ninjaiceflame/MotorizedDobsonian/Documentation/Photos/Week 4/Screenshot_20221017-213734_Amazon Shopping.jpg

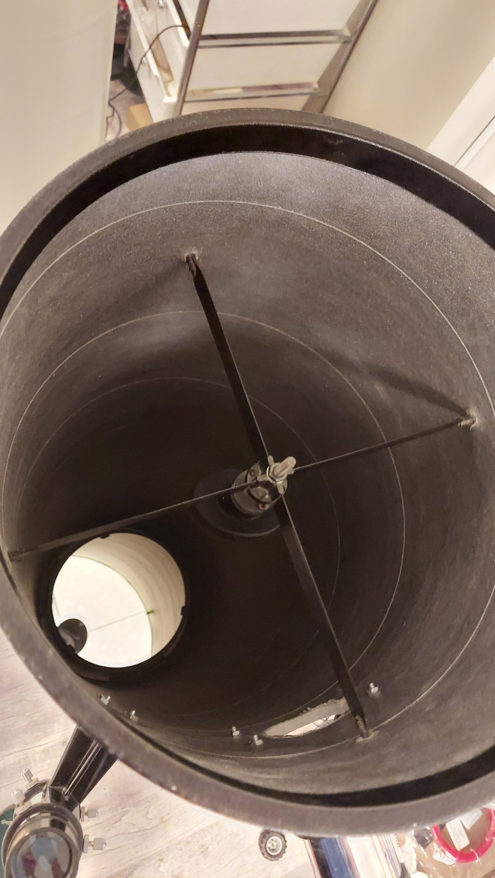
Documentation/Photos/Week 4/Screenshot_20221017-213734_Amazon Shopping.jpg
