ninjaiceflame/MotorizedDobsonian/Documentation/Photos/Week 9/20230317_074437.jpg

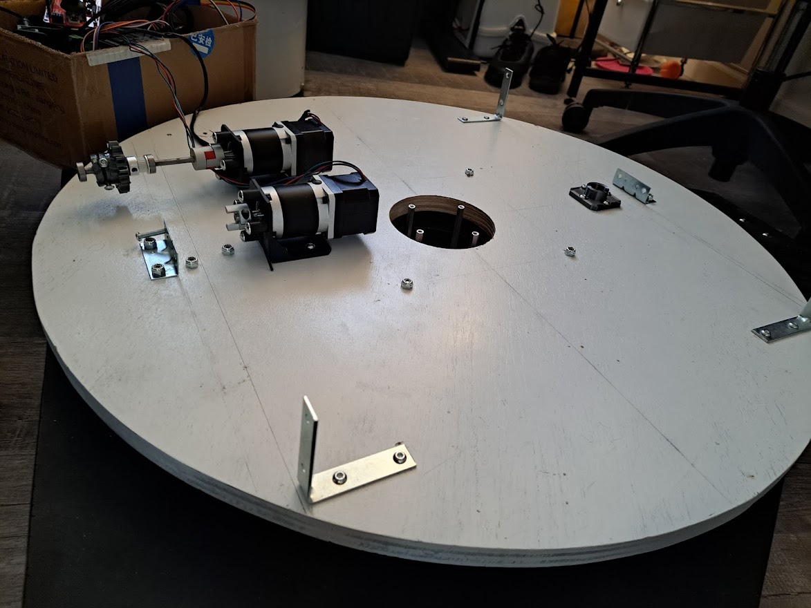
Documentation/Photos/Week 9/20230317_074437.jpg
