ninjaiceflame/MotorizedDobsonian/Documentation/Peer Design Review.pptx

## PEER DESIGN REVIEW Powered Dobsonian Telescope Nathan Wiley

Submitted in partial fulfillment of the requirements of CST471
ESET Senior Project, Oregon Institute of Technology.

## Agenda:

- The Problem and Solution
- Designs, Features, and Progress
- Block Diagram
- Part Selection
- Calculations
- Cost
- Schedule

## The Problem:

Telescopes are not automated enough!
Need to be present to punch in coordinates
- Cold
- Clunky
- Outdated

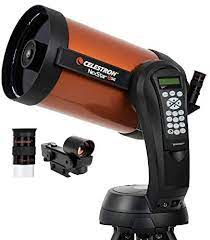
[picture p29: figure]
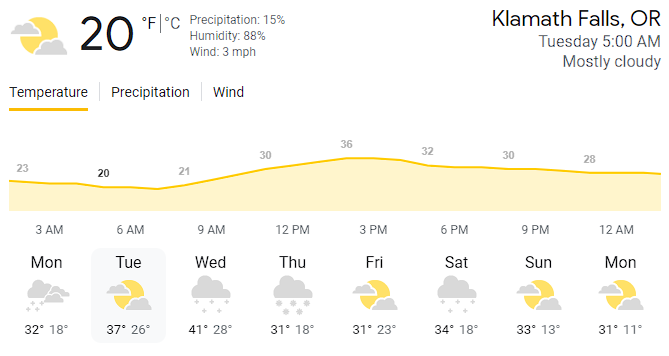
[picture p30: figure]

## The Solution:

Make a telescope that you can control from your couch!

## Design & Features:

Requirements (Very condensed)
1. Shall pivot a telescope
(accuracy to 3600 arcseconds / 1 degree)
2. Shall be able to keep accurate time
3. Shall use a control system
4. Shall have a network interface
5. Shall use a display

Stretch goals
1. May have a camera
2. May use RTC module
3. May include GPS module
4. May include Wi-Fi and Ethernet
5. May include cooling system

## Design process and progress:

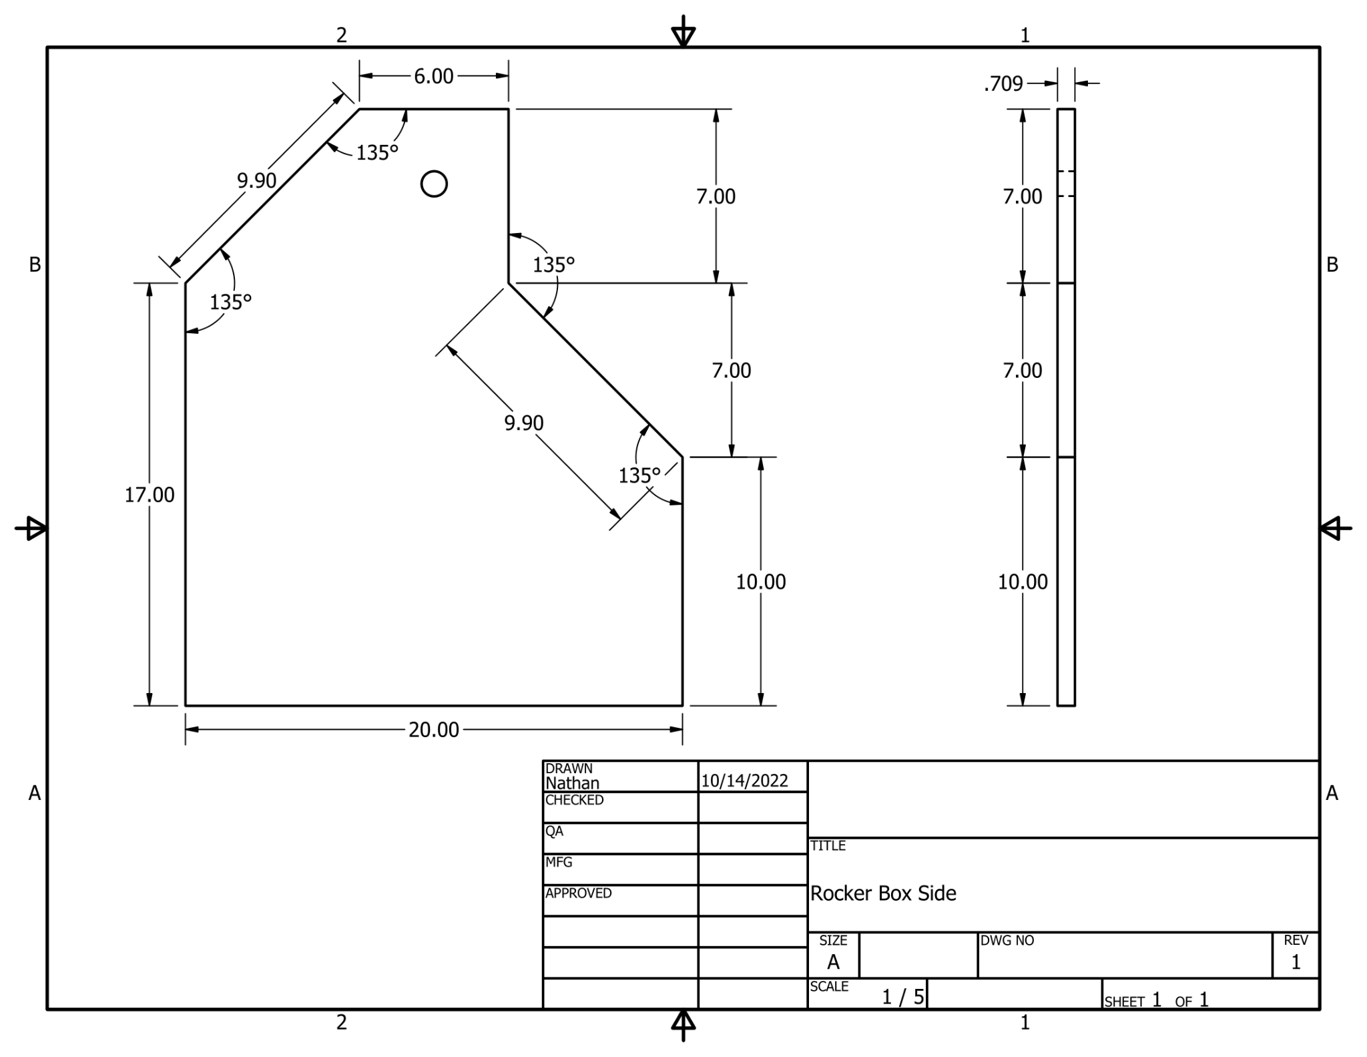
[picture p31: figure]
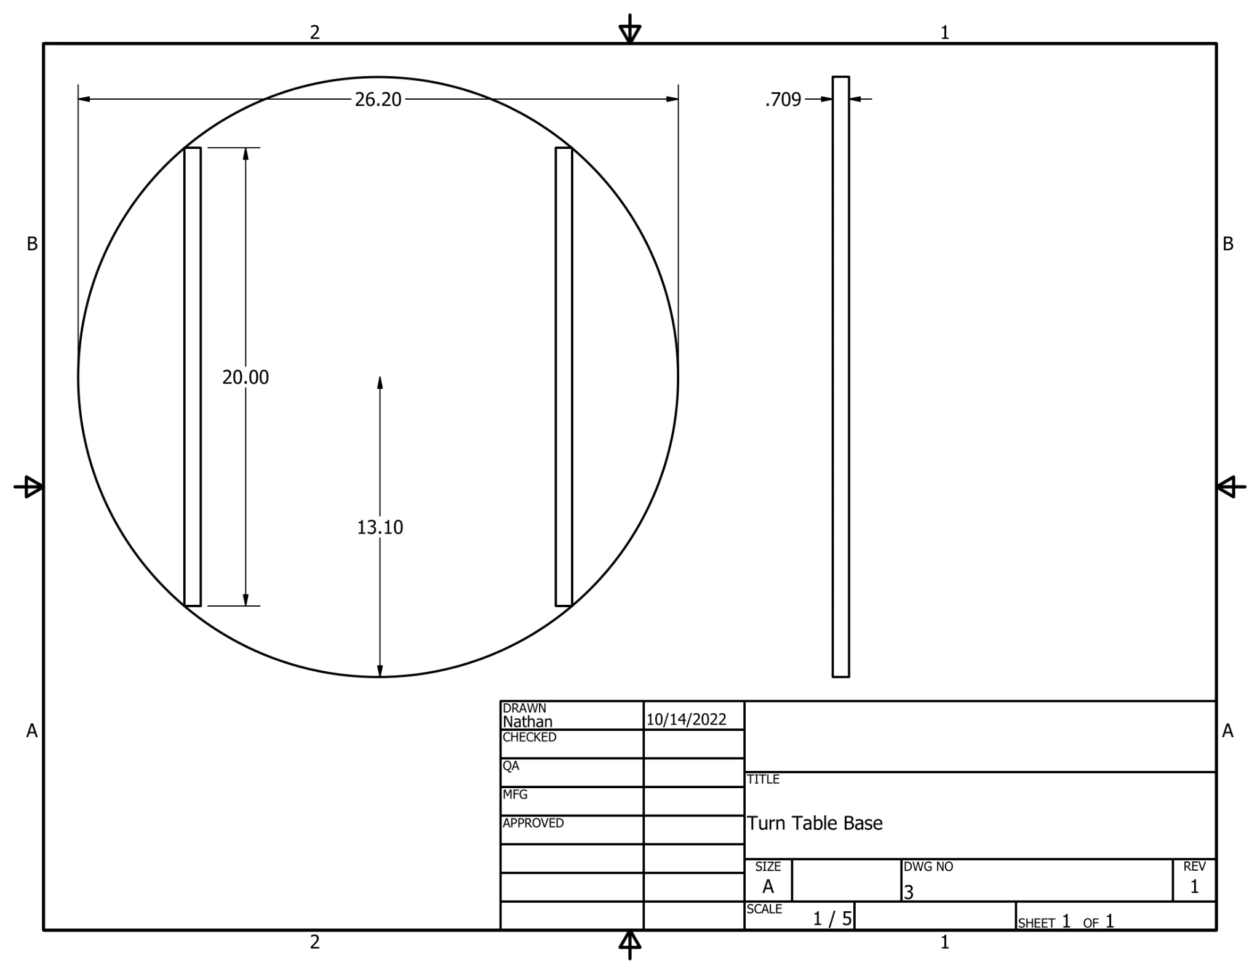
[picture p32: figure]
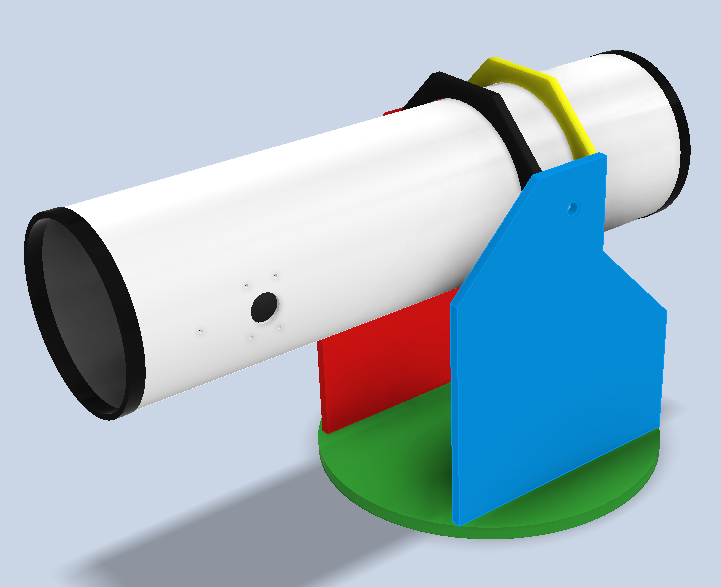
[picture p33: figure]
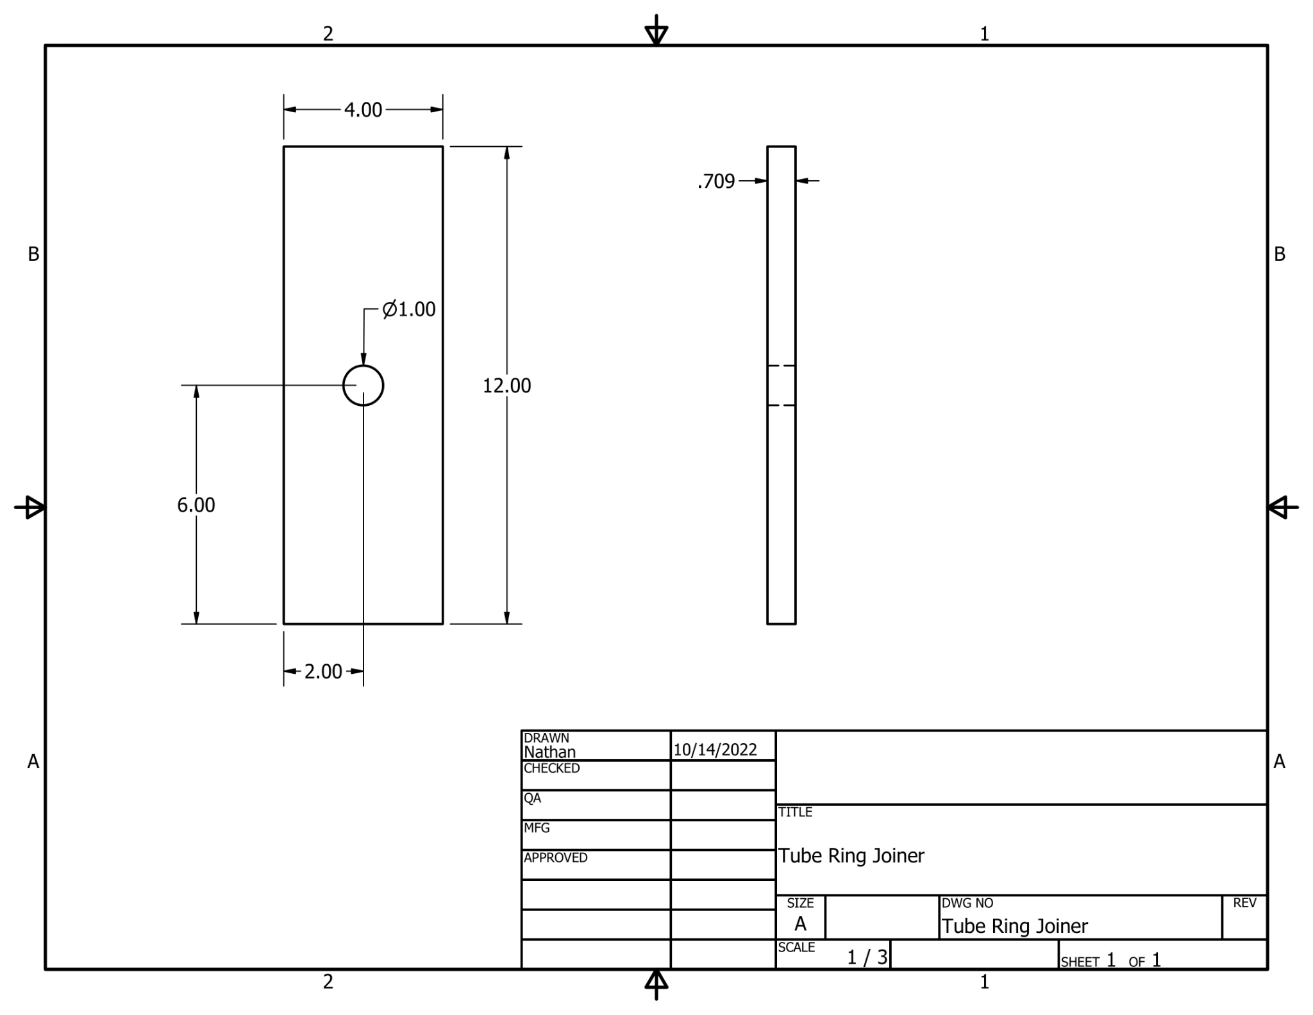
[picture p34: figure]
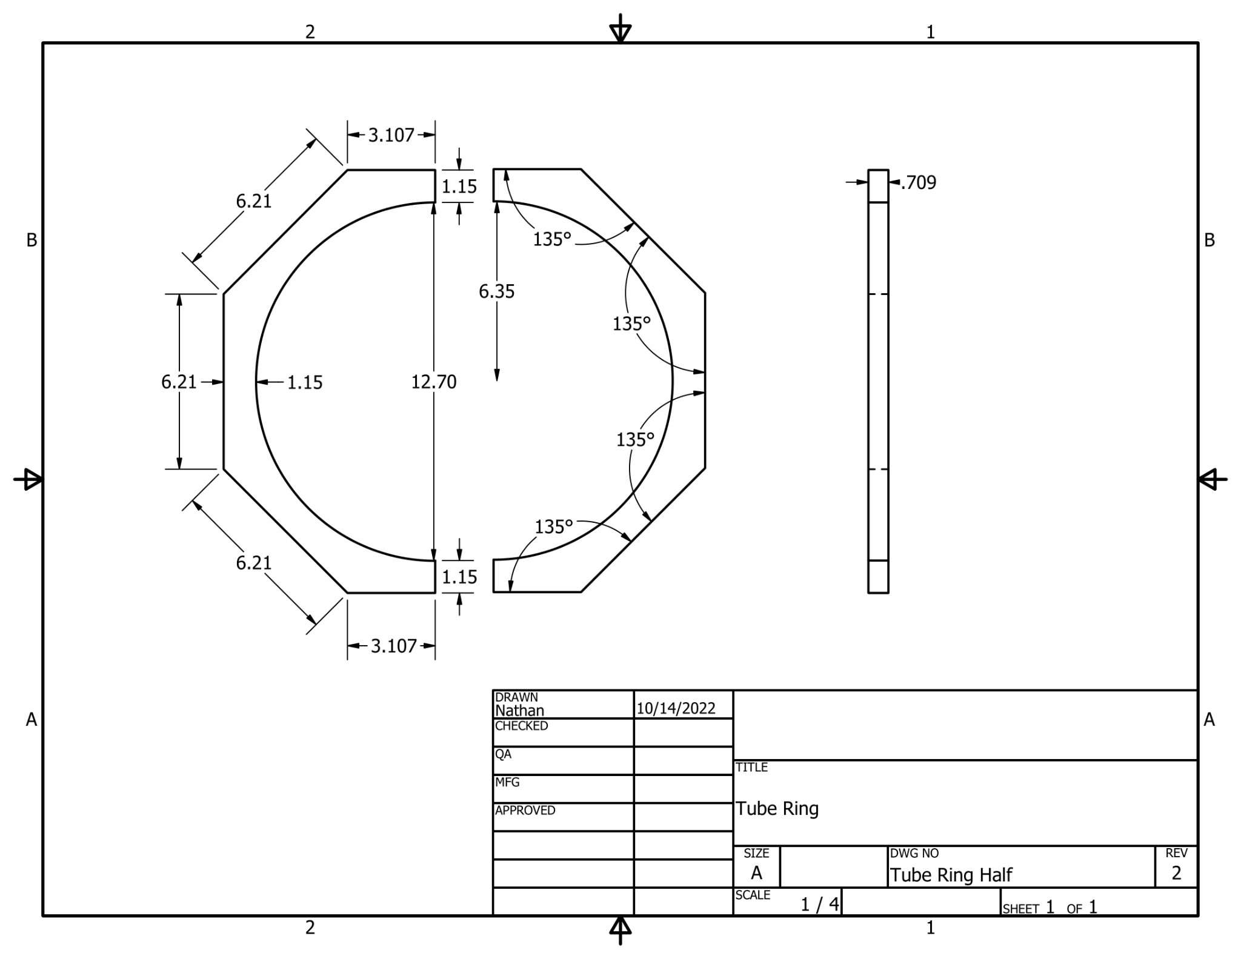
[picture p35: figure]

## Block Diagram:

Camera

Raspberry PI

Stepper Driver

Vertical Motor

Client

Ethernet
Or Wifi

Stepper Driver

Horizontal Motor

Power supply

## Part Selection: Board

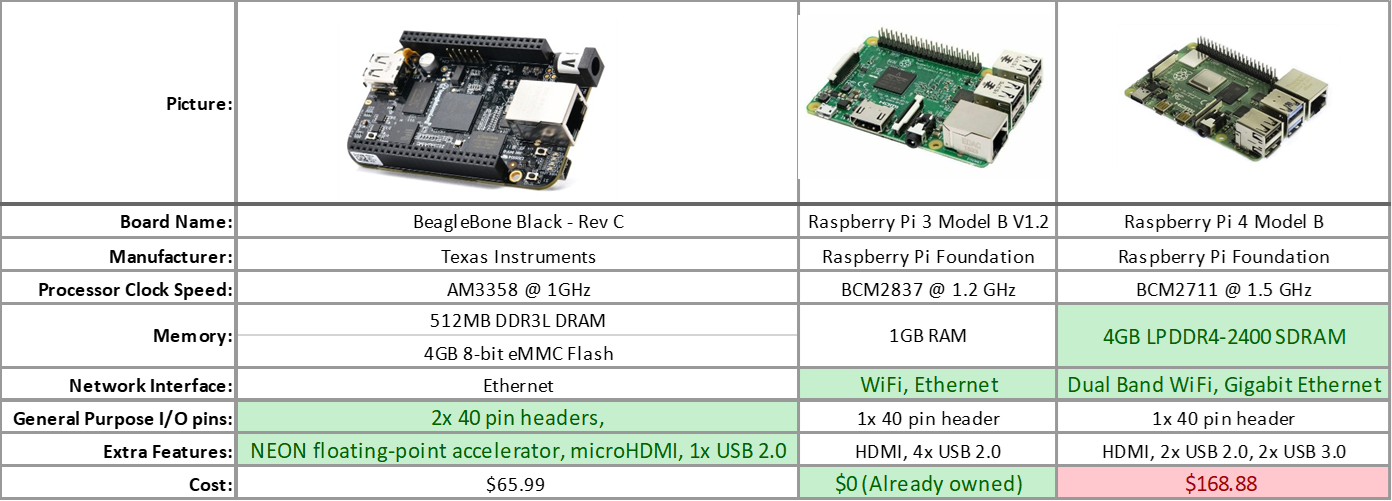
[picture p36: figure]

## Part Selection: Gearing

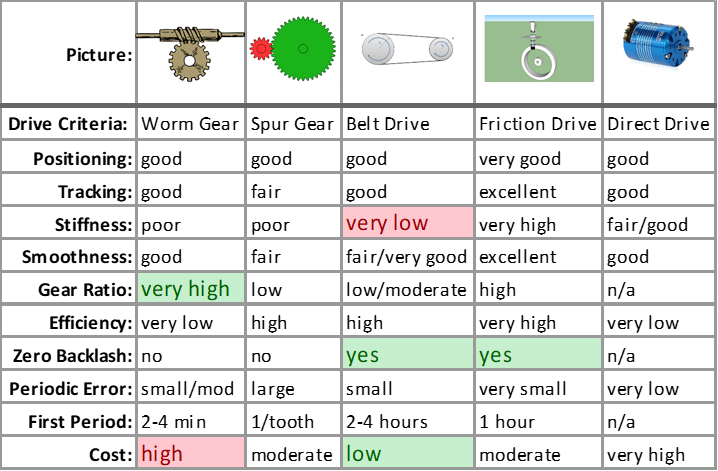
[picture p37: figure]

DFM Engineering, Inc Engineering Article: Comparing Telescope Drive Technologies

## Part Selection: Motorization Type

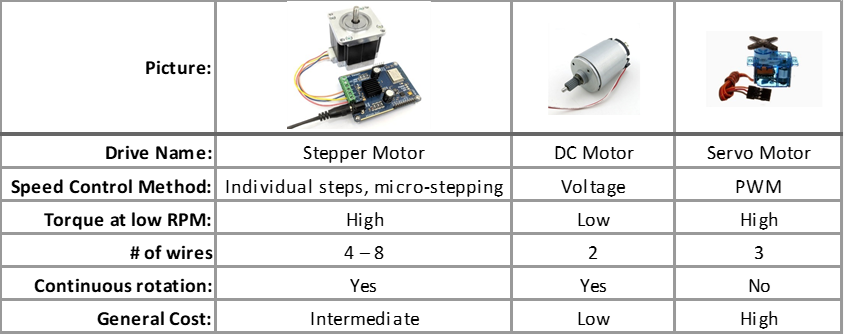
[picture p38: figure]

## Part Selection: Motorization Type

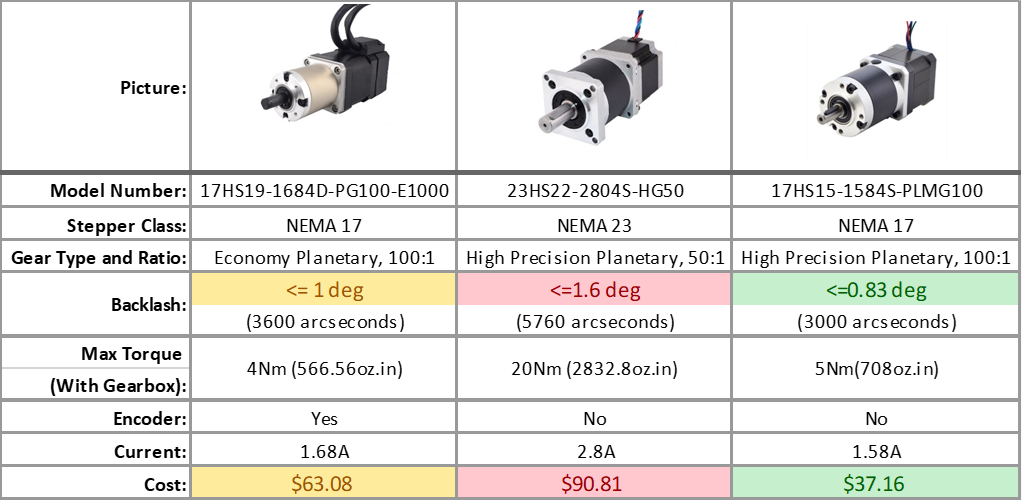
[picture p39: figure]

## Part Selection: Stepper Motor Driver

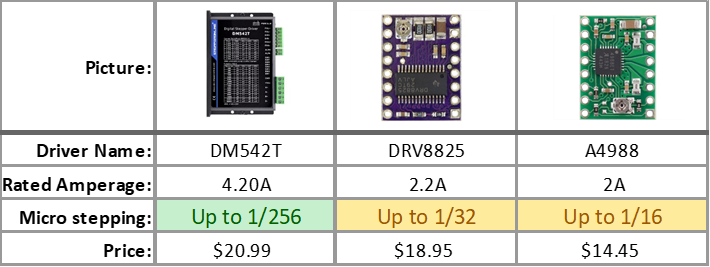
[picture p40: figure]

## Calculations:

1,296,000 arcseconds per 360 degrees, 1 revolution
Stepper motor has 200 steps per revolution, 1.8 degrees per step
100:1 Planetary gear input is attached to motor output
4:1 Belt drive input is attached to planetary gear output
1,296,000 / (200)*(100)*(4) = 16.2 arcseconds (0.0045°) per step
With microstepping it could be even higher precision!

## Cost:

Still Need:
- Belt and pulley
- Camera
- Adjustable zoom eyepiece


## Schedule - Fall Term Chart

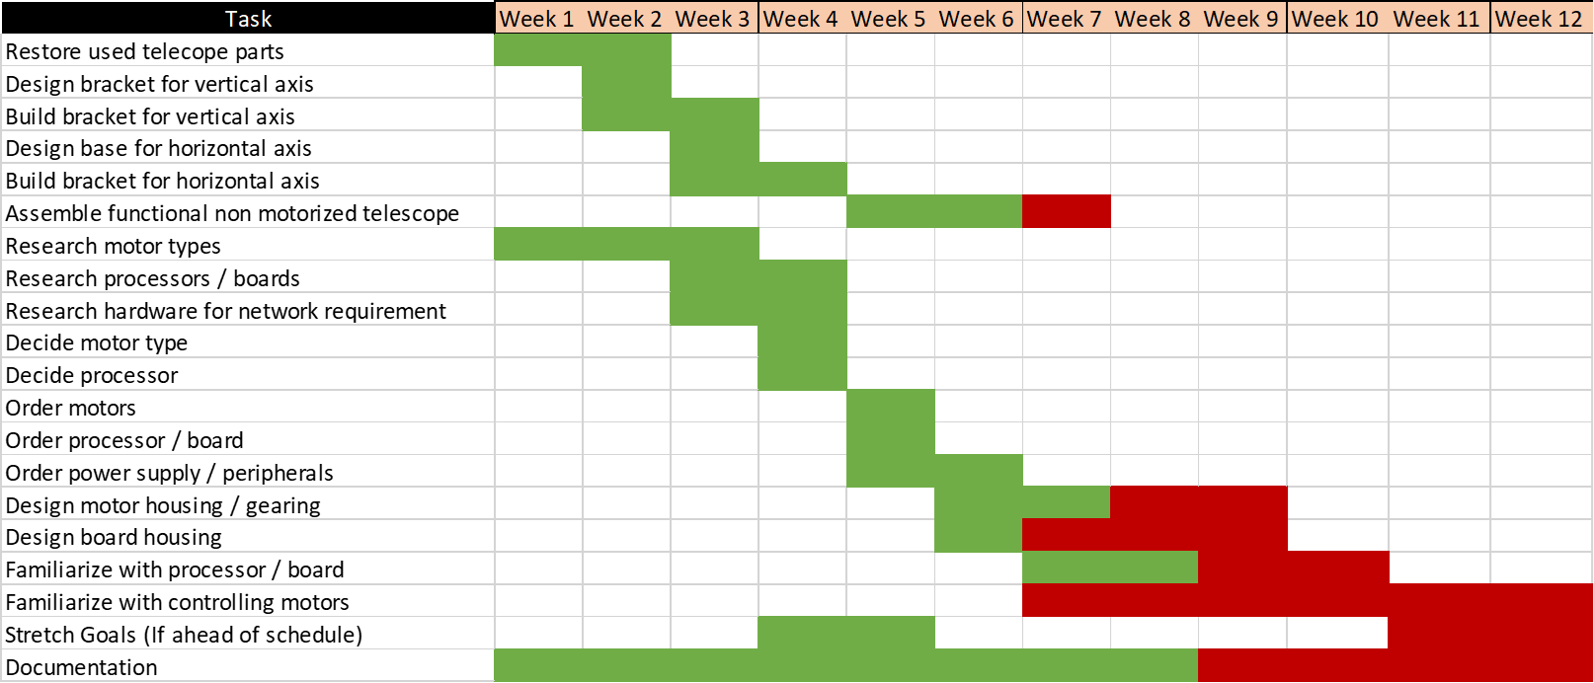
[picture p41: figure]

## Schedule - Tasks for Fall Term

Done
- Design Tube Rings
- Build Tube Rings
- Design Base
- Build Base
- Research motor types
- Research processors
- Decide motor type
- Decide processor
- Order motors
- Order power supply

In progress
- Finish non motorized telescope
- Design motor housing
- Design motor gearing
- Familiarize with processor / board

Not Started
- Familiarize with controlling motors

## Broad Schedule:

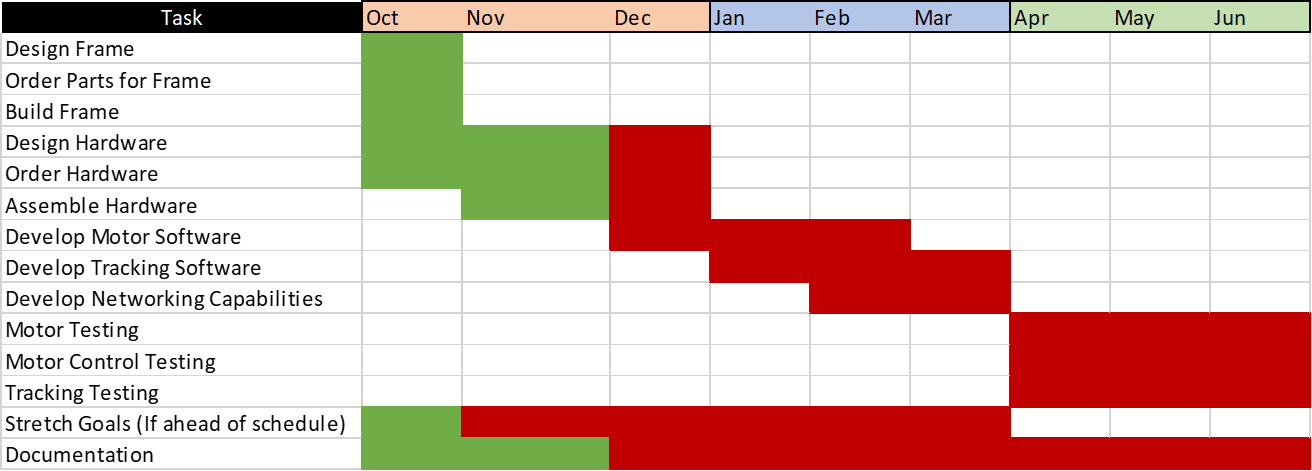
[picture p42: figure]

## Questions?
