ninjaiceflame/MotorizedDobsonian/Documentation/Memos/Memo S2.docx

| Motorized Dobsonian Telescope Project

# Memo

To: | Troy Scevers
From: | Nathan Wiley
Date: | April 21, 2023
Re: | Memo 2

During this period between memos, I worked about 10 hours, mainly fitting electronics into the weatherproof box. I finished rewiring all the connections in the box and have tested it to make sure it still works after putting it all back together. I am still having some slippage on the vertical 3D printed gear, and I’m not sure what to do to fix it. I might need to consider a metal alternative.

In the next few weeks, I will make the test plan for the project. I still need to make some changes to my code and test it aswell.

The schedule is as follows below:

Picture of the moon taken through the telescope:

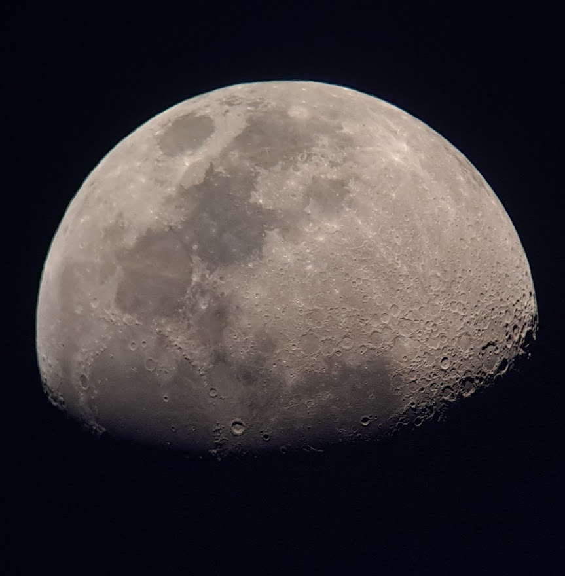
[picture p94: figure]

Picture of electronics box:

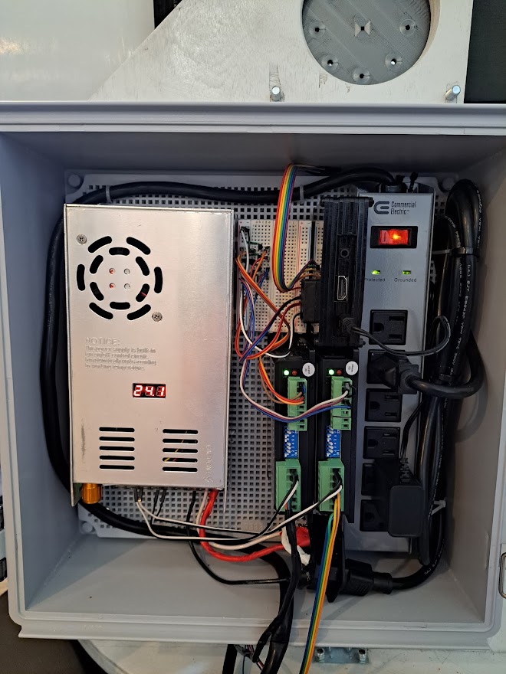
[picture p95: figure]
