ninjaiceflame/MotorizedDobsonian/Documentation/Labels/labels.docx

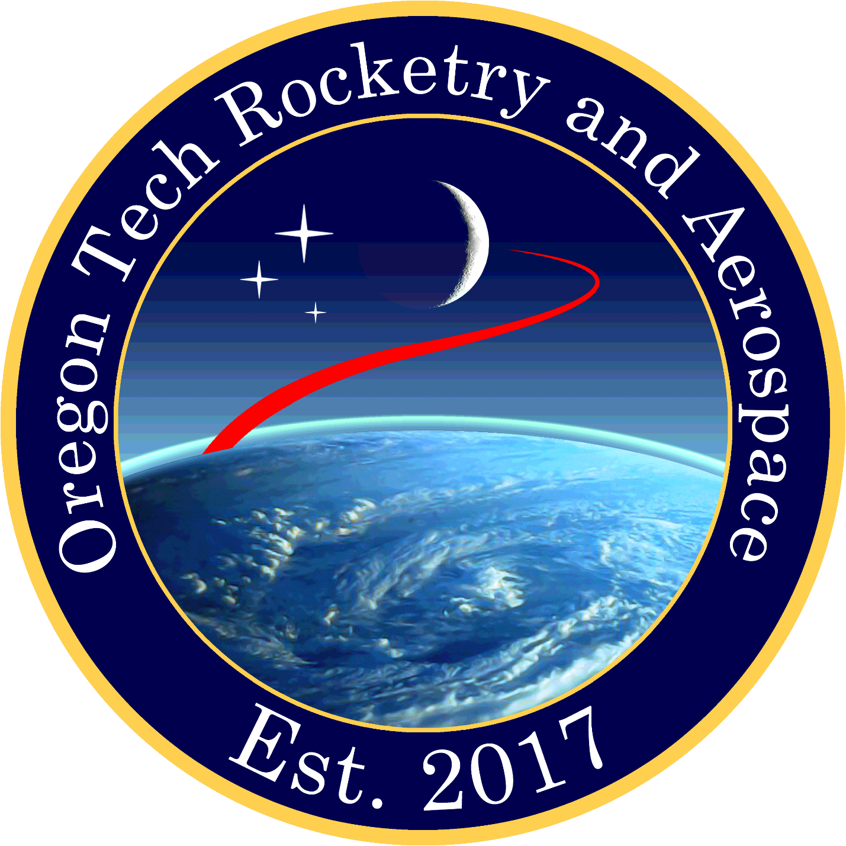
[picture p100: figure]
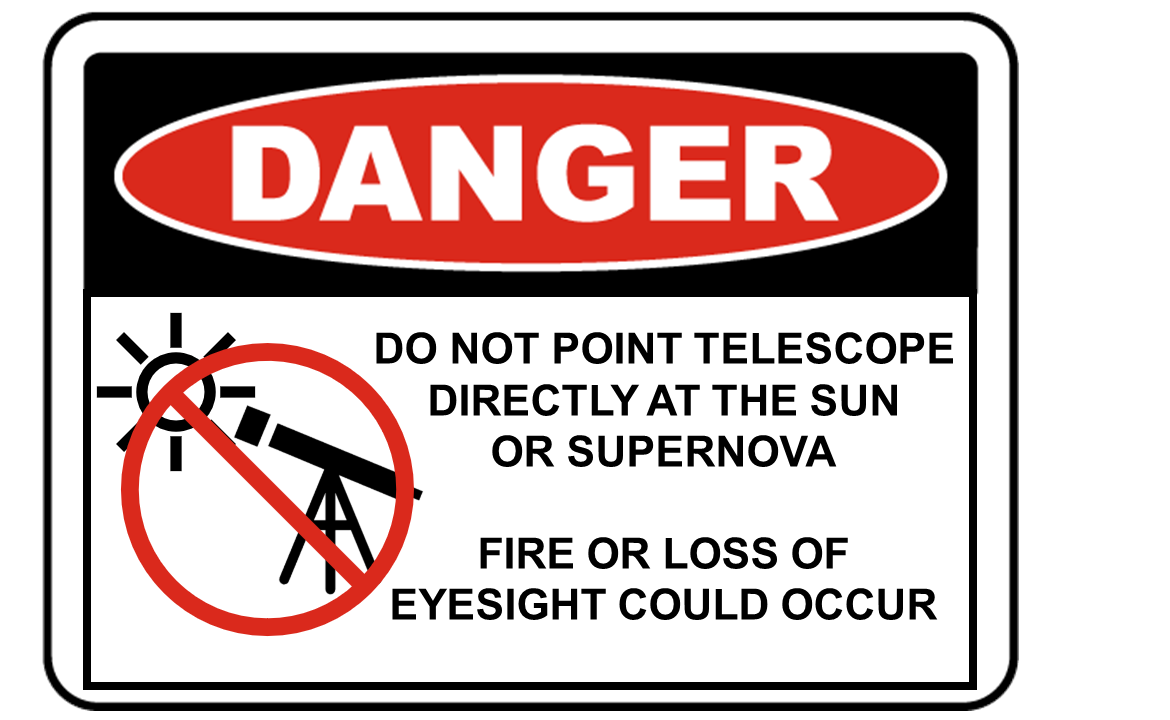
[picture p101: figure]
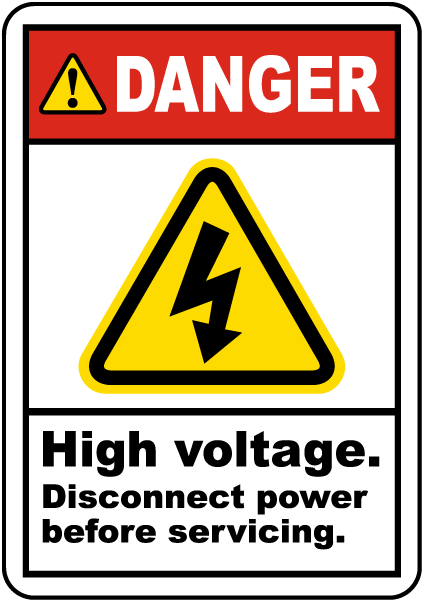
[picture p102: figure]
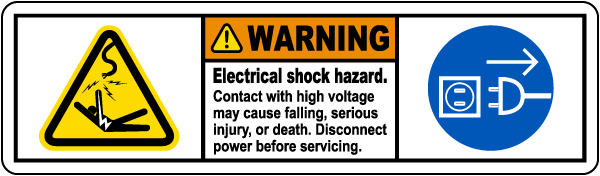
[picture p103: figure]
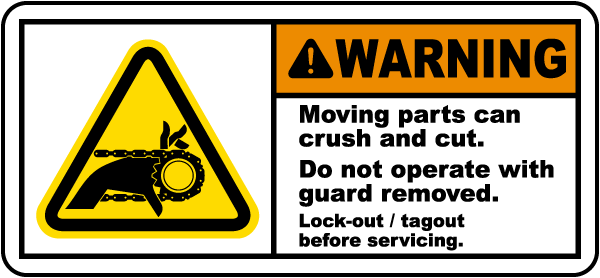
[picture p104: figure]
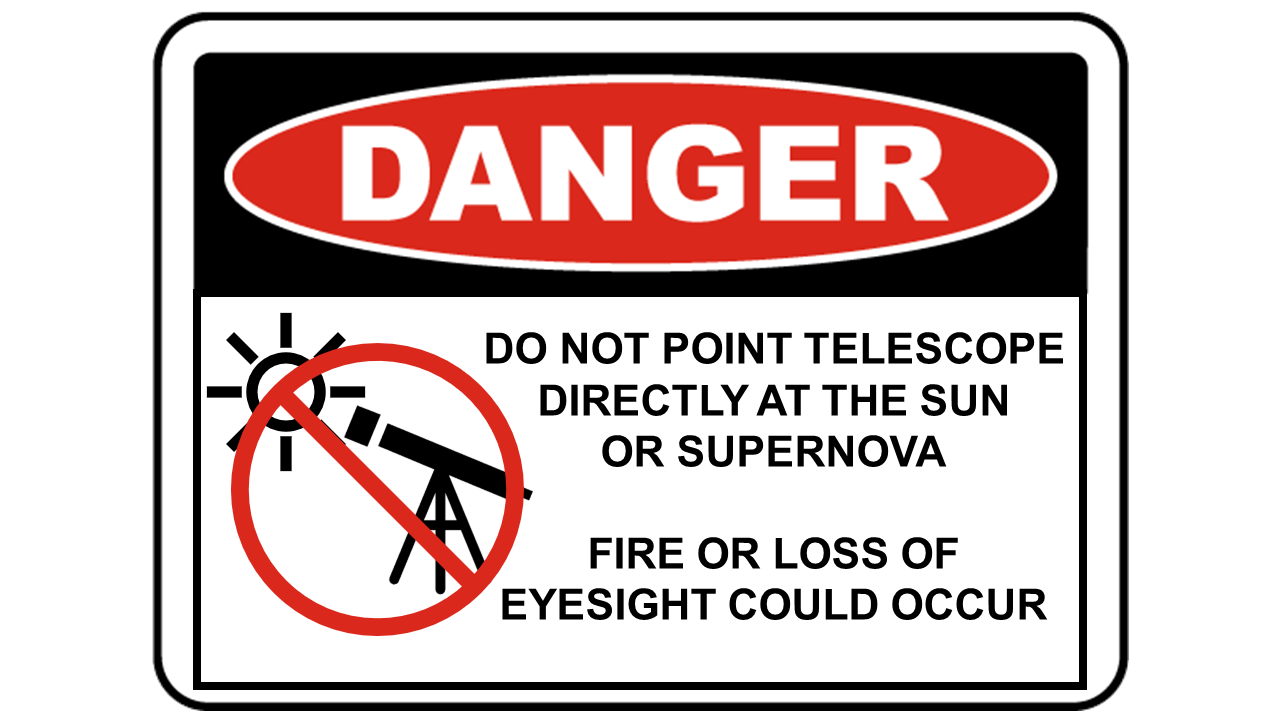
[picture p105: figure]
