ninjaiceflame/MotorizedDobsonian/Documentation/Labels/sun damage.pptx

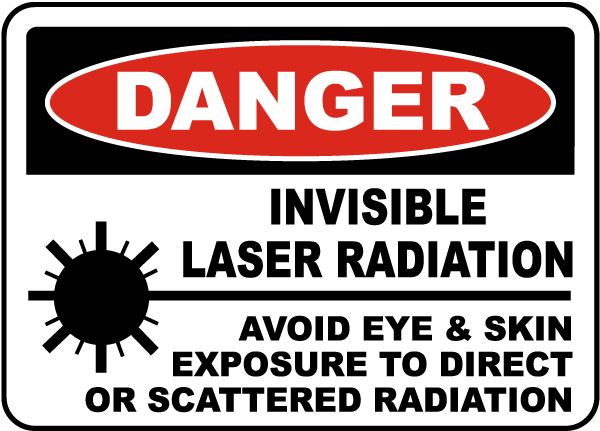
[picture p106: figure]

DO NOT POINT TELESCOPE
DIRECTLY AT THE SUN
OR SUPERNOVA
FIRE OR LOSS OF EYESIGHT COULD OCCUR

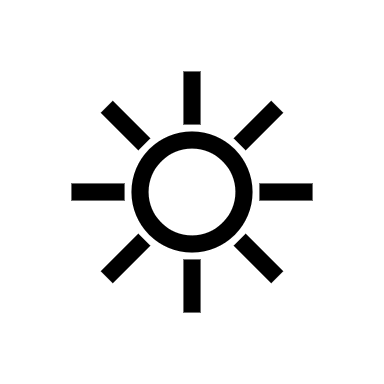
[picture p107: figure]
Dim (Smaller Sun) outline
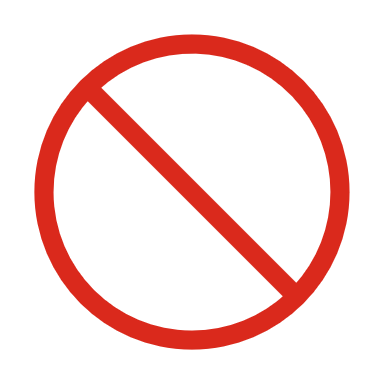
[picture p108: figure]
No sign outline
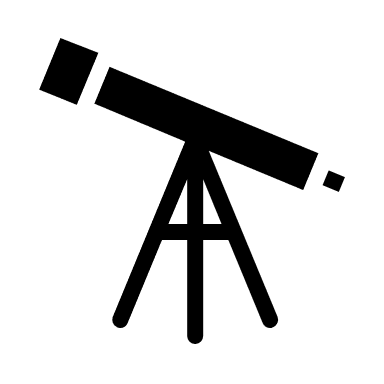
[picture p109: figure]
Telescope with solid fill
