ninjaiceflame/MotorizedDobsonian/Documentation/Capture2.PNG

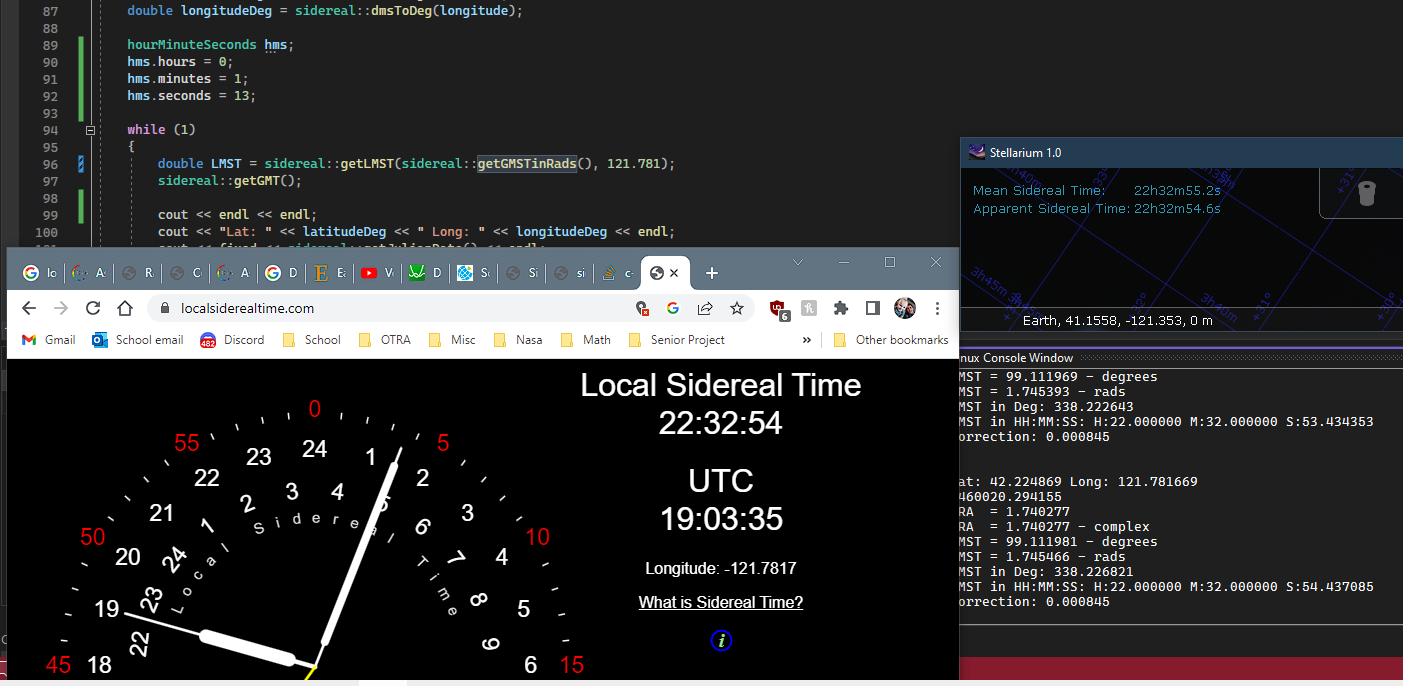
Documentation/Capture2.PNG
