ninjaiceflame/MotorizedDobsonian/Documentation/Labels/J6016.png

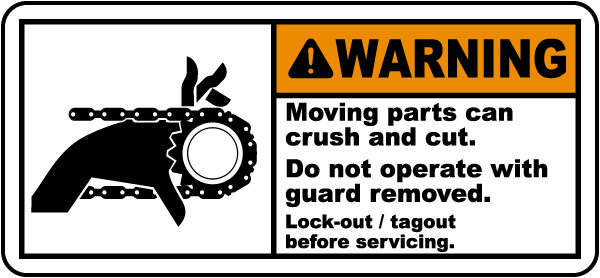
Documentation/Labels/J6016.png
