ninjaiceflame/MotorizedDobsonian/Documentation/Labels/J6738-electrostatic-label.png

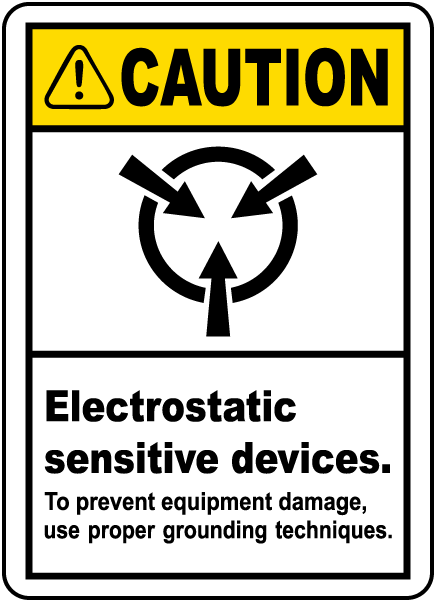
Documentation/Labels/J6738-electrostatic-label.png
