ninjaiceflame/MotorizedDobsonian/Documentation/Photos/misc/AHUB_132133079317219709cPLb3RH1a0.jpg

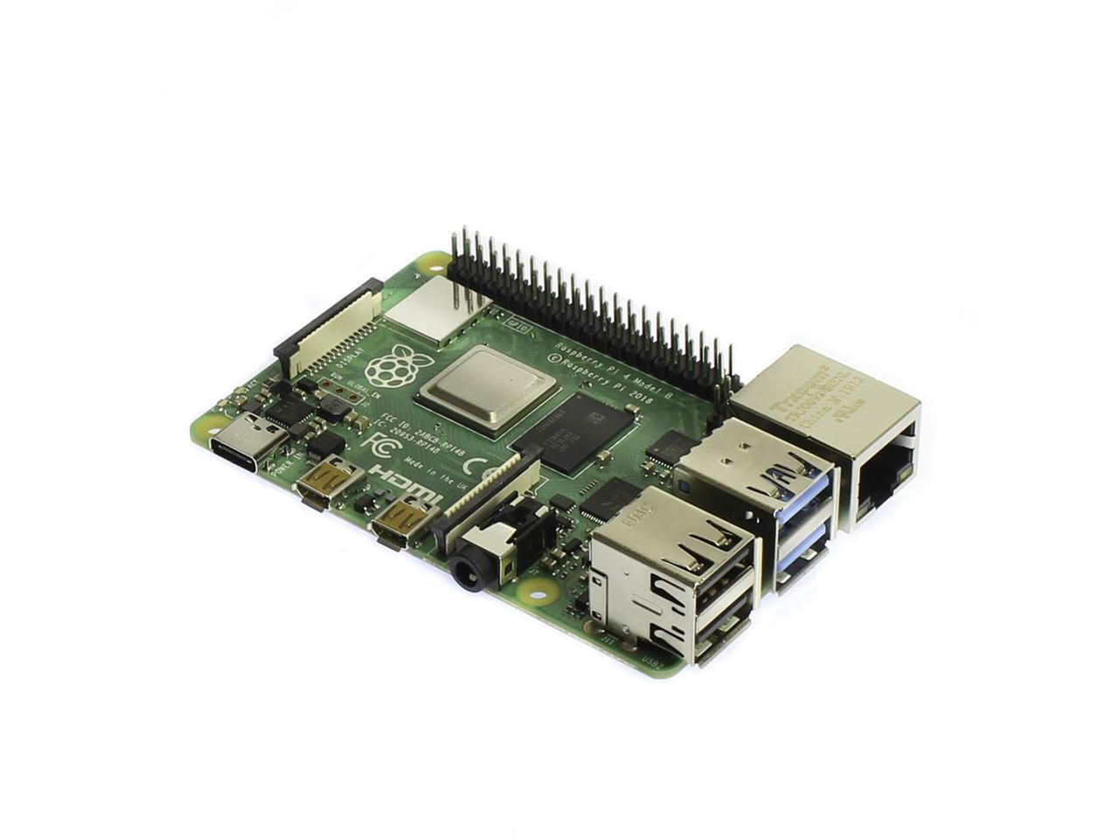
Documentation/Photos/misc/AHUB_132133079317219709cPLb3RH1a0.jpg
