ninjaiceflame/MotorizedDobsonian/Documentation/Photos/misc/Nema-17-Stepper-Motor-Bipolar-L-48mm-w-Gear-Ratio-100-1-Planetary-Gearbox-550x550.jpg

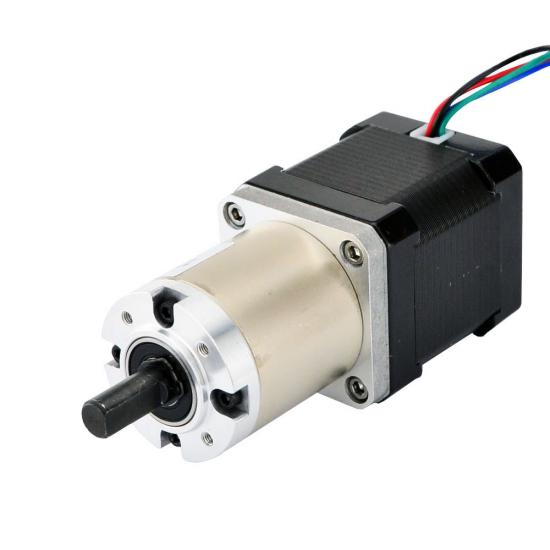
Documentation/Photos/misc/Nema-17-Stepper-Motor-Bipolar-L-48mm-w-Gear-Ratio-100-1-Planetary-Gearbox-550x550.jpg
