ninjaiceflame/MotorizedDobsonian/Documentation/Photos/misc/vs.PNG

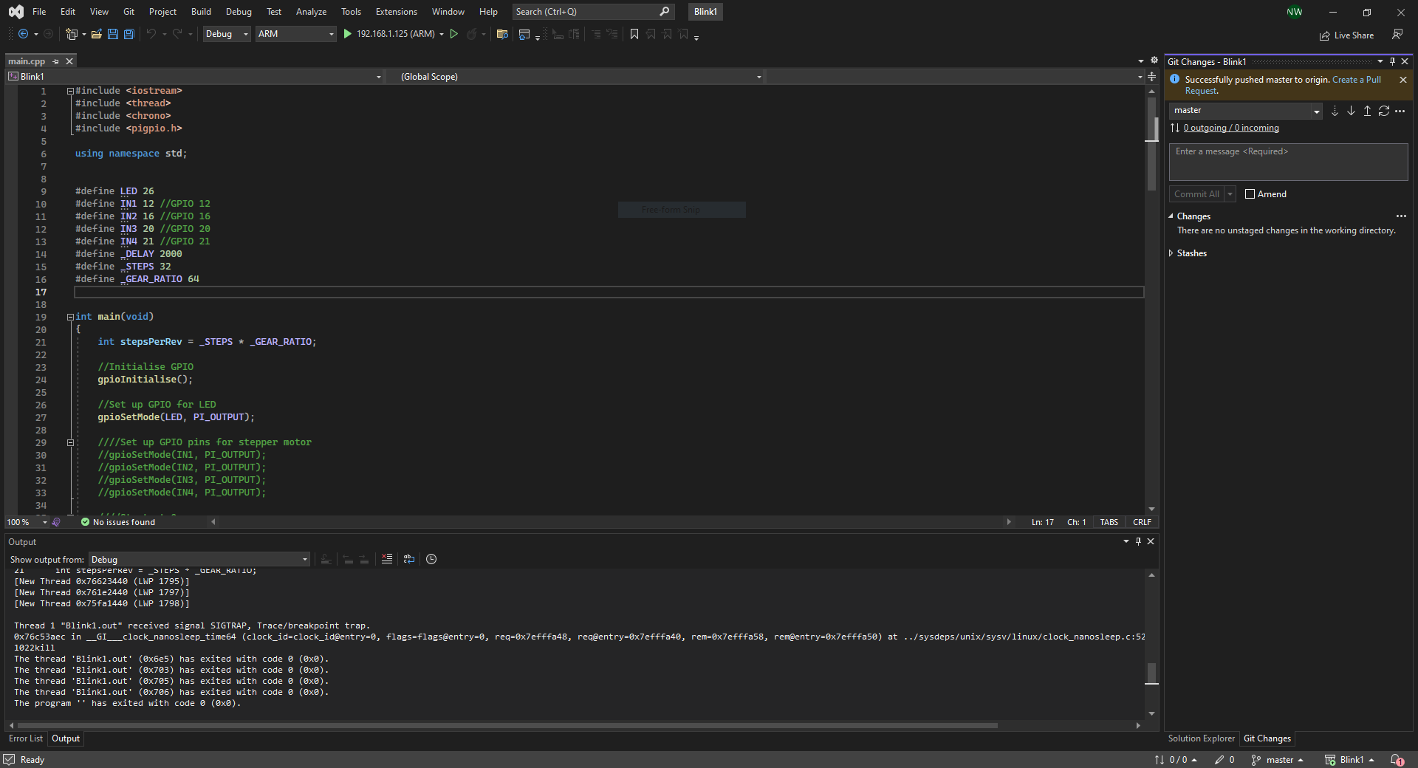
Documentation/Photos/misc/vs.PNG
