ninjaiceflame/MotorizedDobsonian/Documentation/Photos/Spring 2023/20230514_201312.jpg

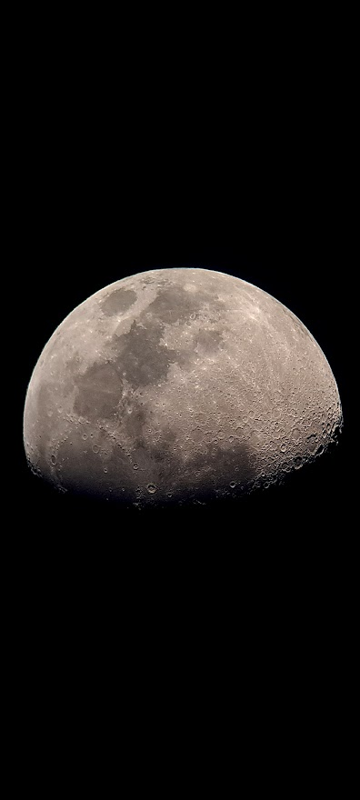
Documentation/Photos/Spring 2023/20230514_201312.jpg
