ninjaiceflame/MotorizedDobsonian/Documentation/Photos/Spring 2023/20230526_130842.jpg

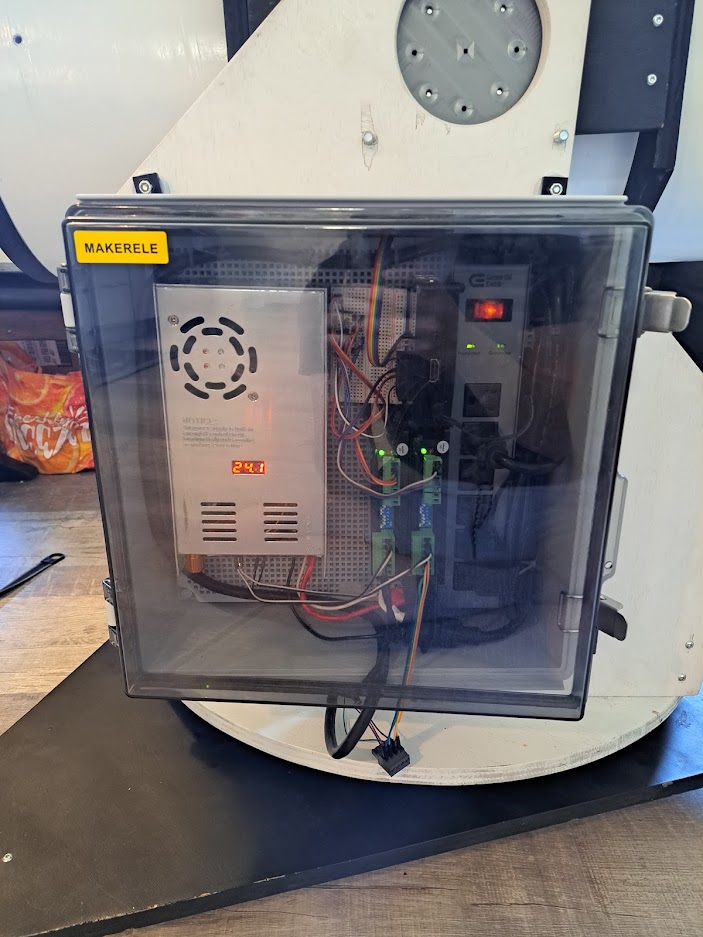
Documentation/Photos/Spring 2023/20230526_130842.jpg
