ninjaiceflame/MotorizedDobsonian/Documentation/Photos/Spring 2023/20230526_130858.jpg

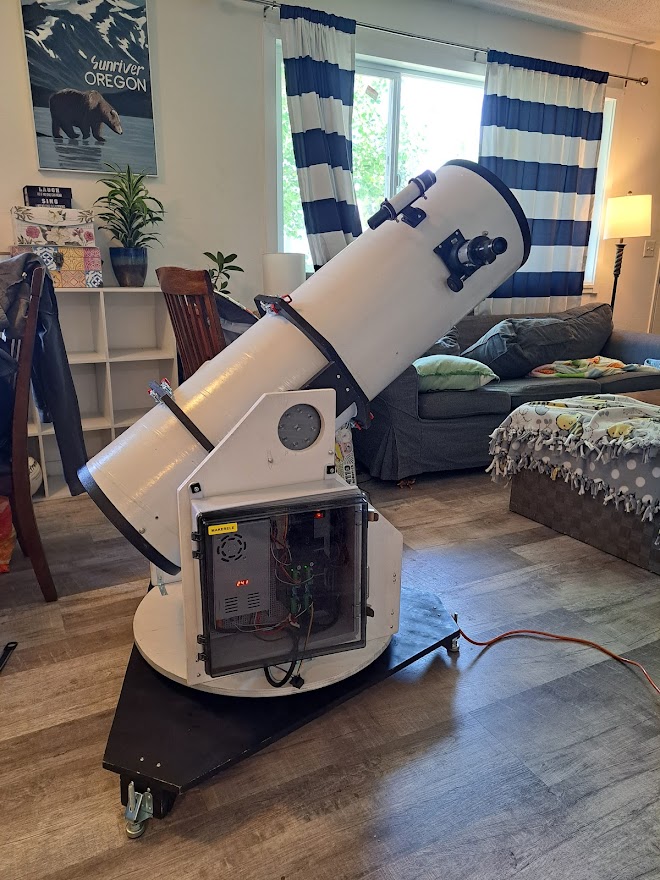
Documentation/Photos/Spring 2023/20230526_130858.jpg
