ninjaiceflame/MotorizedDobsonian/Documentation/Photos/Week 1/20220630_123644.jpg

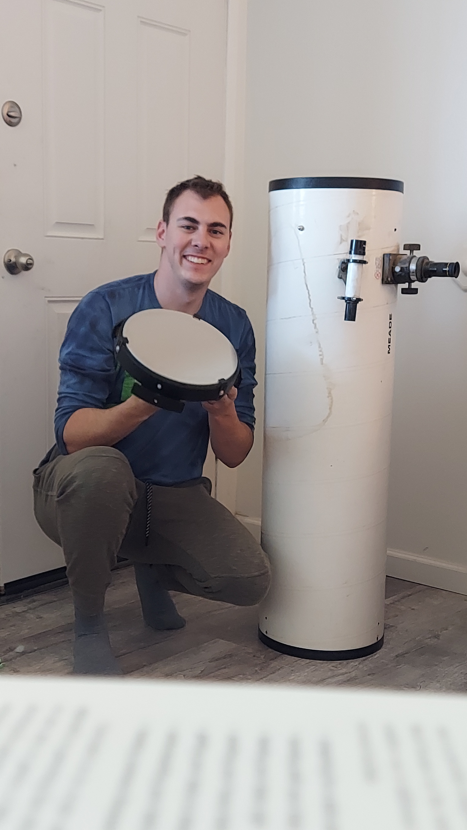
Documentation/Photos/Week 1/20220630_123644.jpg
