ninjaiceflame/MotorizedDobsonian/Documentation/Photos/Week 1/20221007_145958.jpg

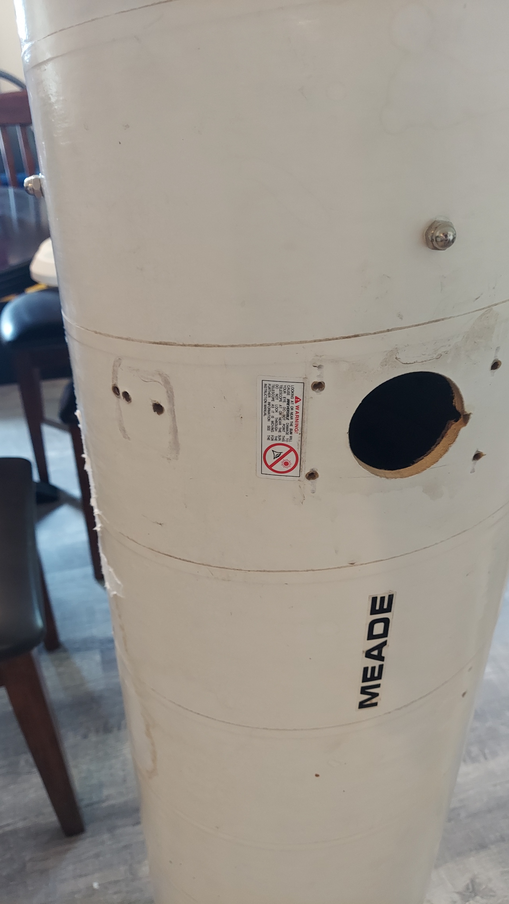
Documentation/Photos/Week 1/20221007_145958.jpg
