ninjaiceflame/MotorizedDobsonian/Documentation/Photos/Week 1/20221007_150006.jpg

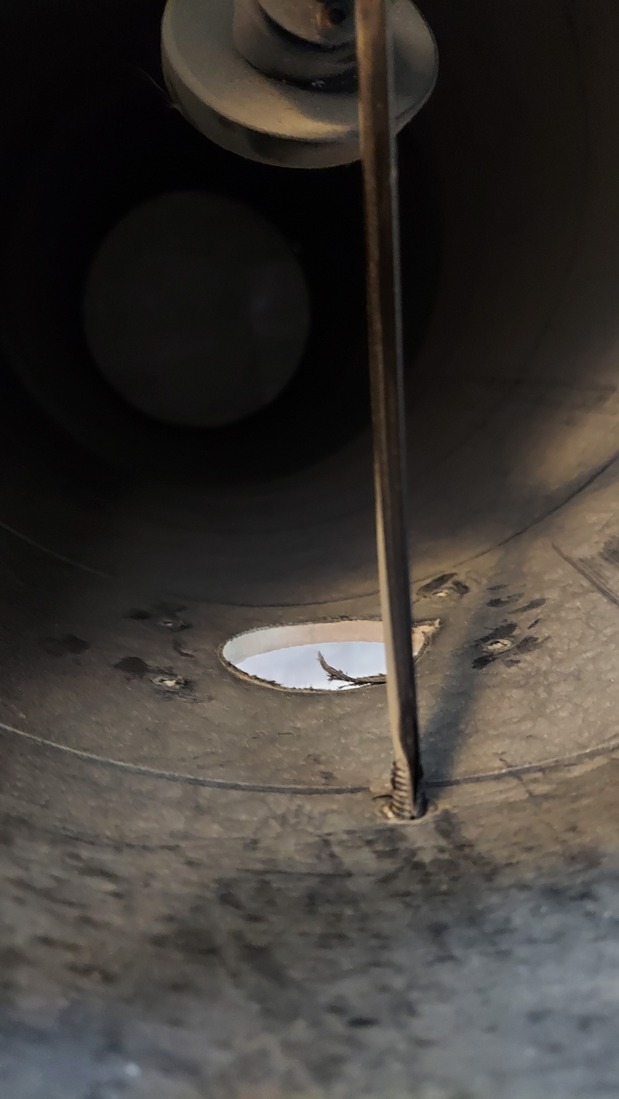
Documentation/Photos/Week 1/20221007_150006.jpg
