ninjaiceflame/MotorizedDobsonian/Documentation/Photos/Week 1/20221007_153721.jpg

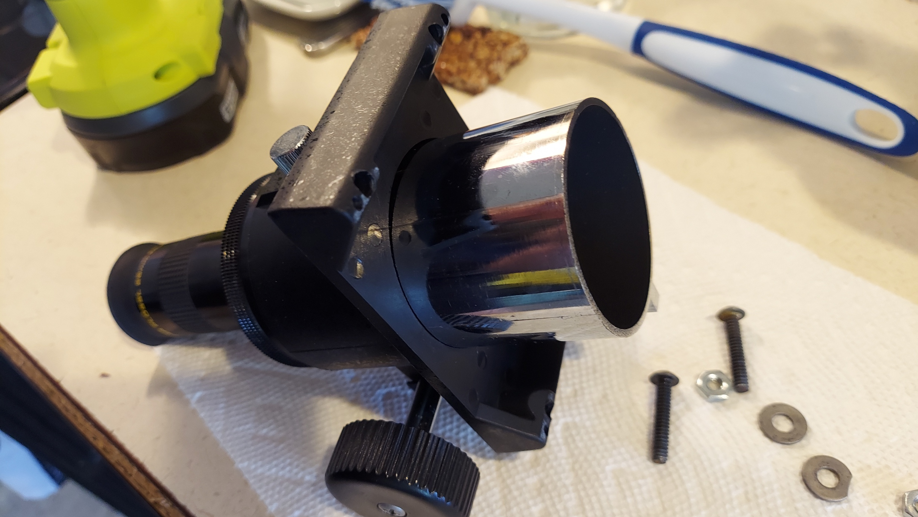
Documentation/Photos/Week 1/20221007_153721.jpg
