ninjaiceflame/MotorizedDobsonian/Documentation/Photos/Week 1/20221007_153757.jpg

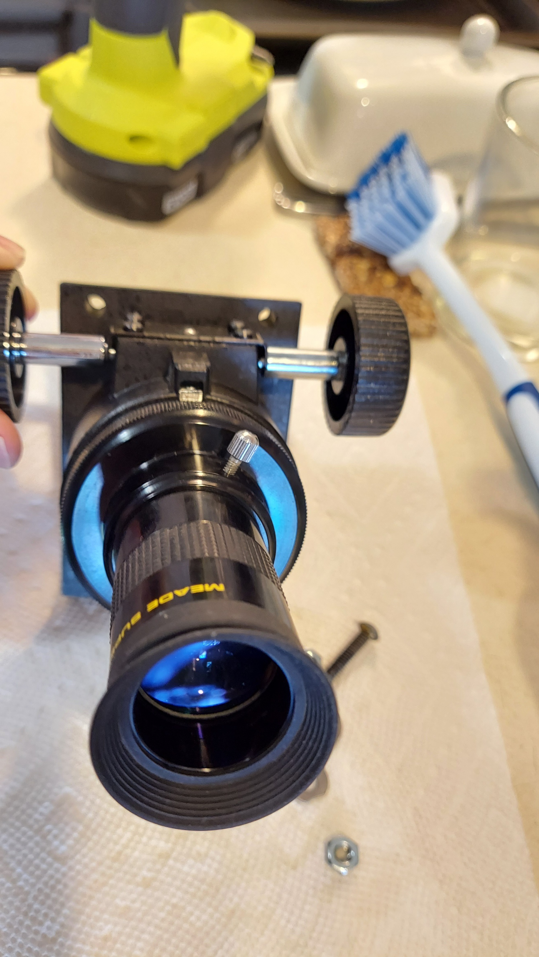
Documentation/Photos/Week 1/20221007_153757.jpg
