ninjaiceflame/MotorizedDobsonian/Documentation/Photos/Week 1/20221007_185040.jpg

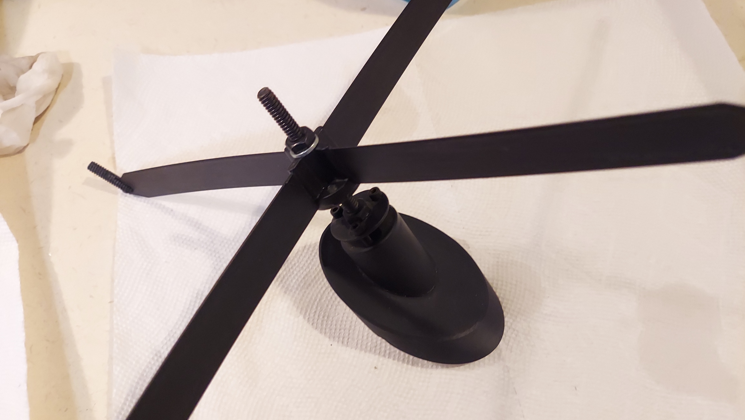
Documentation/Photos/Week 1/20221007_185040.jpg
