ninjaiceflame/MotorizedDobsonian/Documentation/Photos/Week 2/bracket.PNG

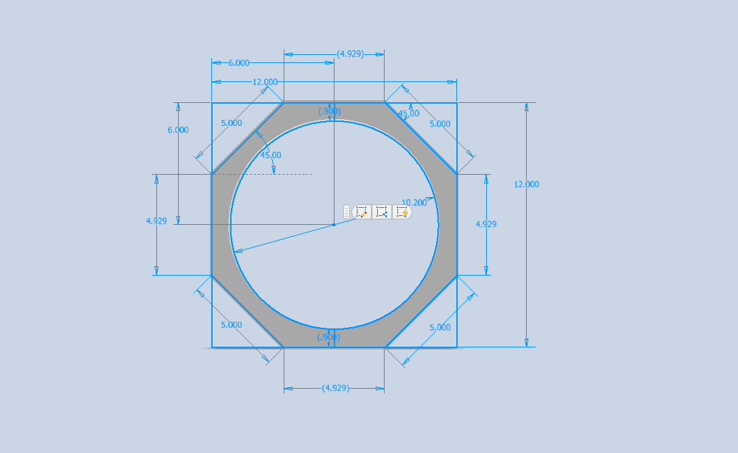
Documentation/Photos/Week 2/bracket.PNG
