ninjaiceflame/MotorizedDobsonian/Documentation/Photos/Week 2/panel.PNG

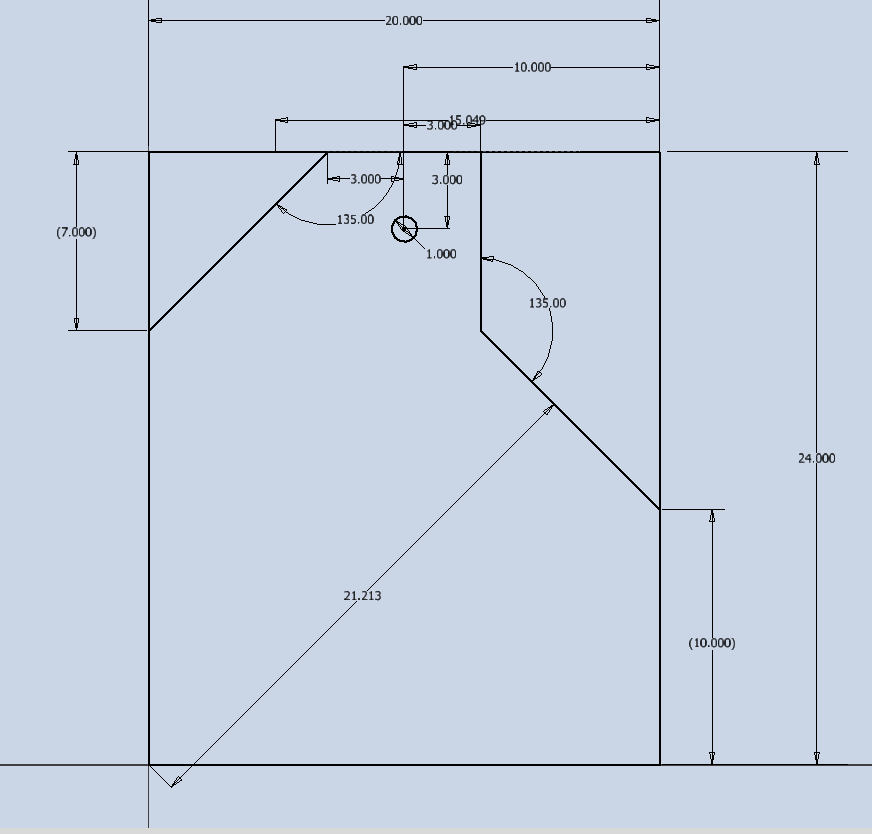
Documentation/Photos/Week 2/panel.PNG
