ninjaiceflame/MotorizedDobsonian/Documentation/Photos/Week 3/20221021_200640.jpg

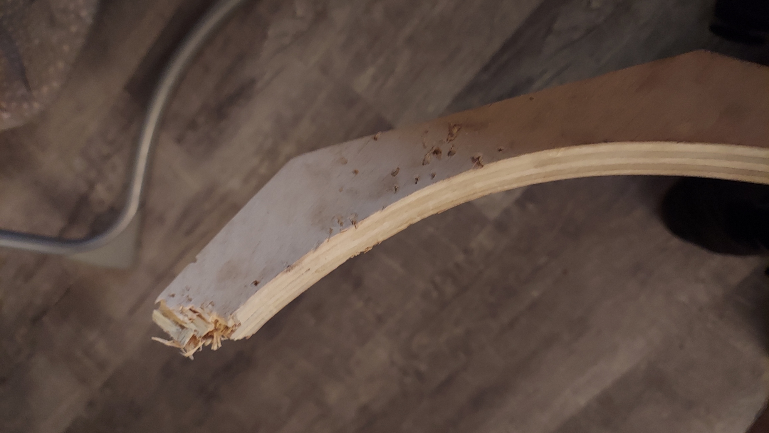
Documentation/Photos/Week 3/20221021_200640.jpg
