ninjaiceflame/MotorizedDobsonian/Documentation/Photos/Week 3/20221021_202020.jpg

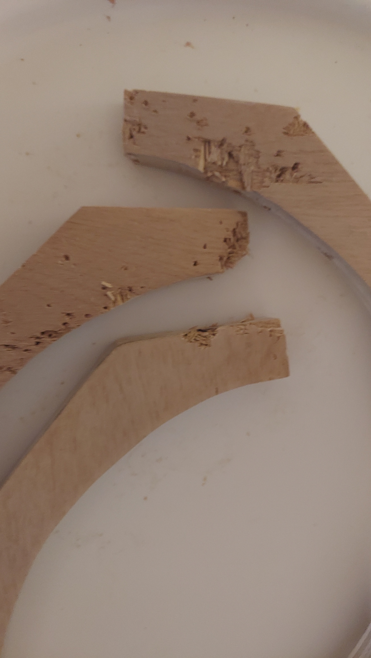
Documentation/Photos/Week 3/20221021_202020.jpg
