ninjaiceflame/MotorizedDobsonian/Documentation/Photos/Week 3/20221021_204918.jpg

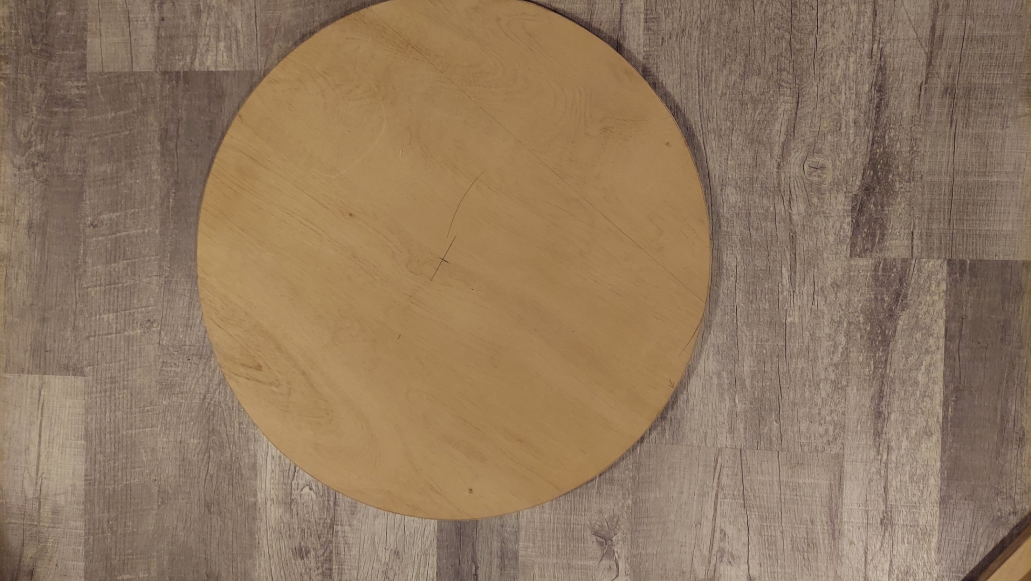
Documentation/Photos/Week 3/20221021_204918.jpg
