ninjaiceflame/MotorizedDobsonian/Documentation/Photos/Week 3/20221021_205021.jpg

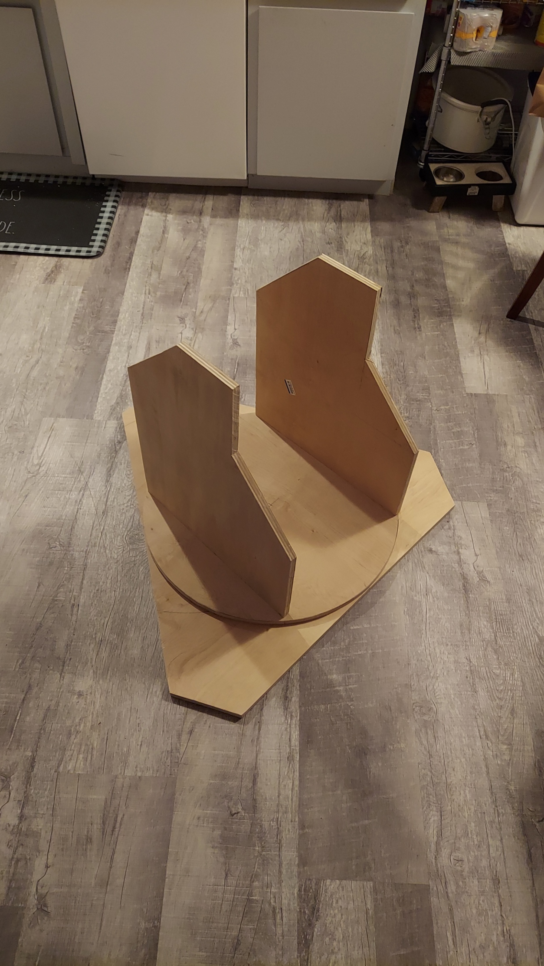
Documentation/Photos/Week 3/20221021_205021.jpg
