ninjaiceflame/MotorizedDobsonian/Documentation/Photos/Week 3/20221021_205026.jpg

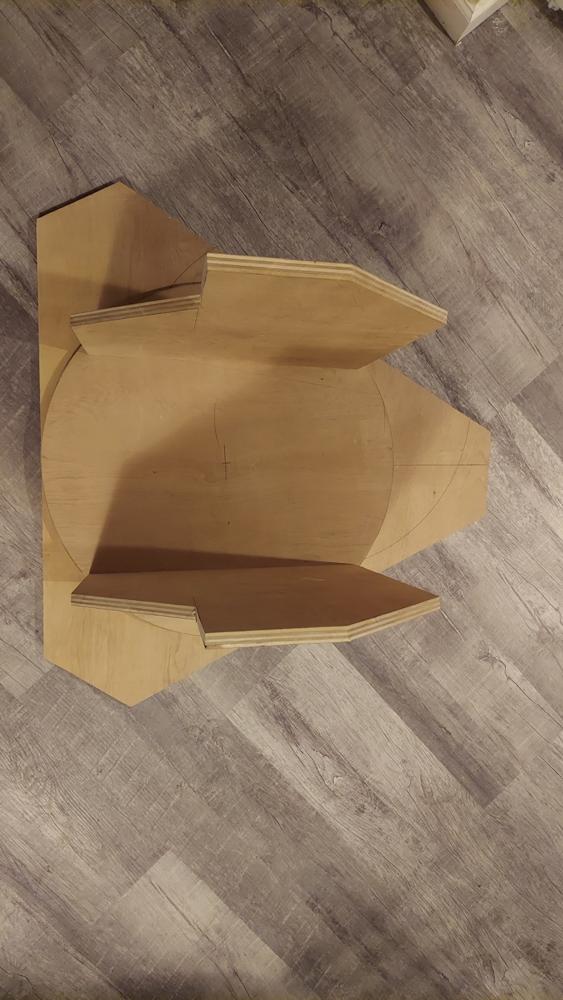
Documentation/Photos/Week 3/20221021_205026.jpg
