ninjaiceflame/MotorizedDobsonian/Documentation/Photos/Week 4/20221022_204949.jpg

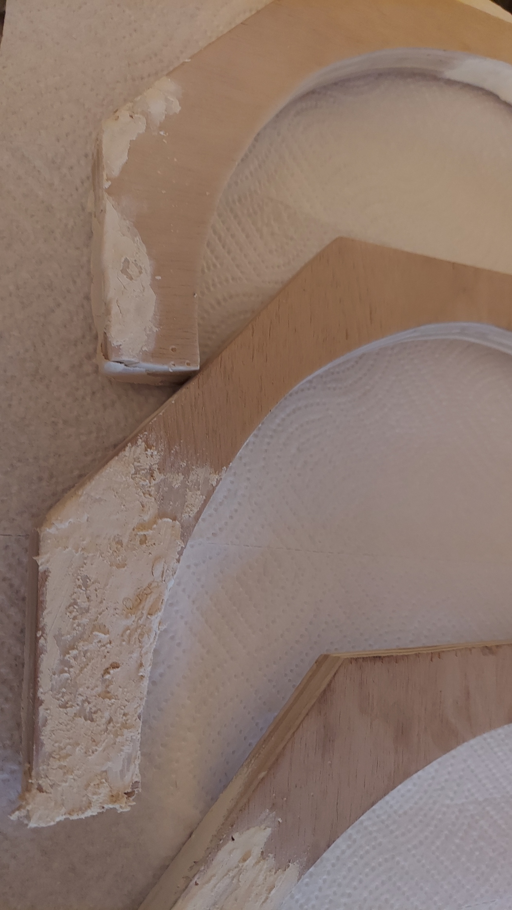
Documentation/Photos/Week 4/20221022_204949.jpg
