ninjaiceflame/MotorizedDobsonian/Documentation/Photos/Week 4/20221022_205009.jpg

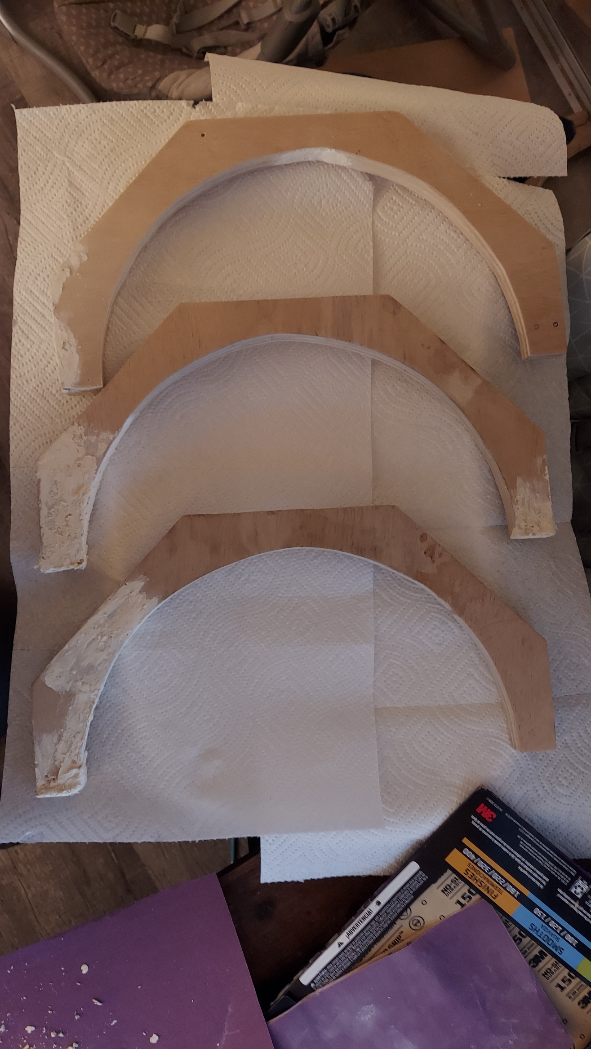
Documentation/Photos/Week 4/20221022_205009.jpg
