ninjaiceflame/MotorizedDobsonian/Documentation/Photos/Week 4/20221023_221938.jpg

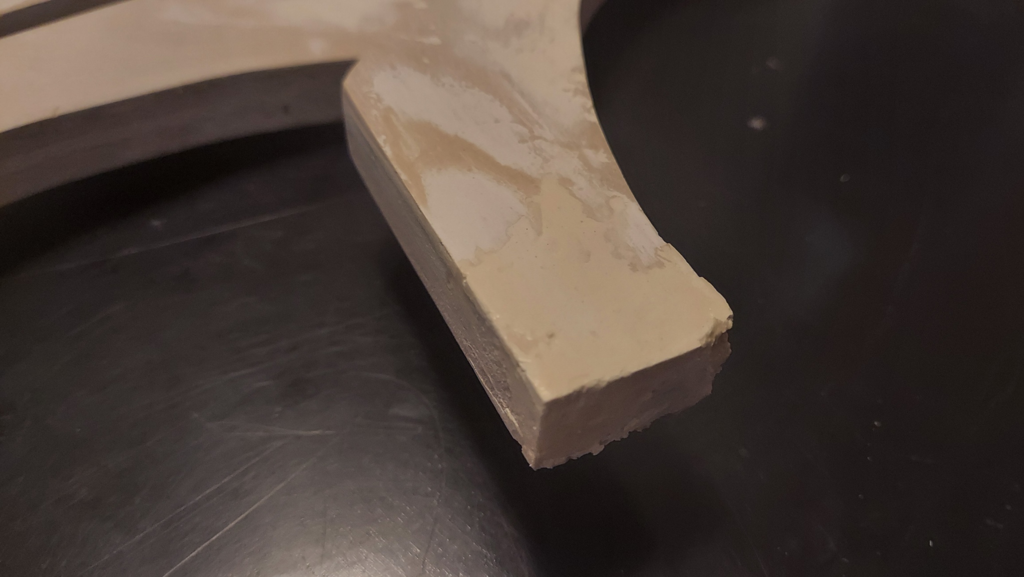
Documentation/Photos/Week 4/20221023_221938.jpg
