ninjaiceflame/MotorizedDobsonian/Documentation/Photos/Week 4/20221024_090950.jpg

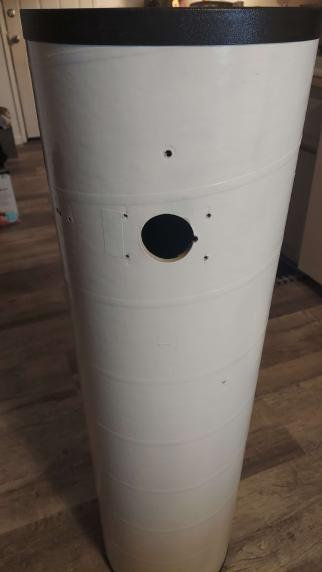
Documentation/Photos/Week 4/20221024_090950.jpg
