ninjaiceflame/MotorizedDobsonian/Documentation/Photos/Week 4/20221026_130149.jpg

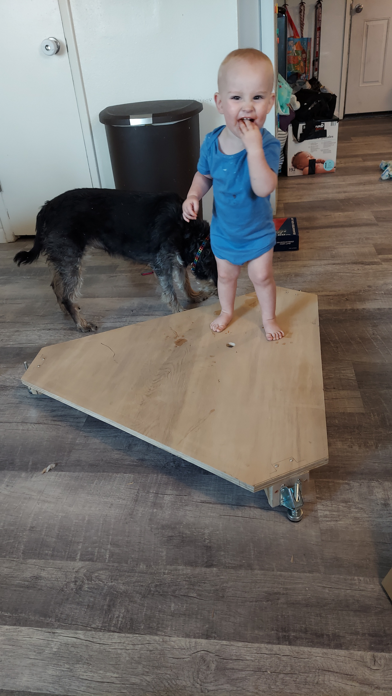
Documentation/Photos/Week 4/20221026_130149.jpg
