ninjaiceflame/MotorizedDobsonian/Documentation/Photos/Week 4/20221026_220909.jpg

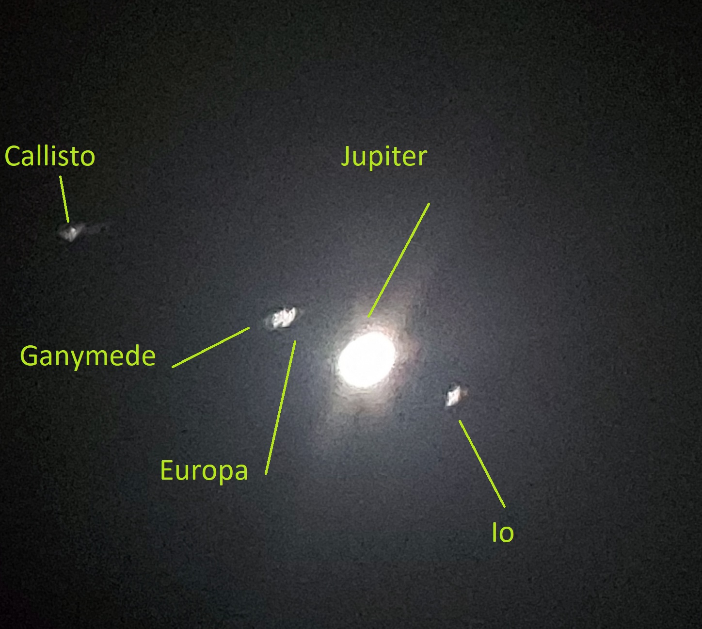
Documentation/Photos/Week 4/20221026_220909.jpg
