ninjaiceflame/MotorizedDobsonian/Documentation/Photos/Week 4/20221028_220442.jpg

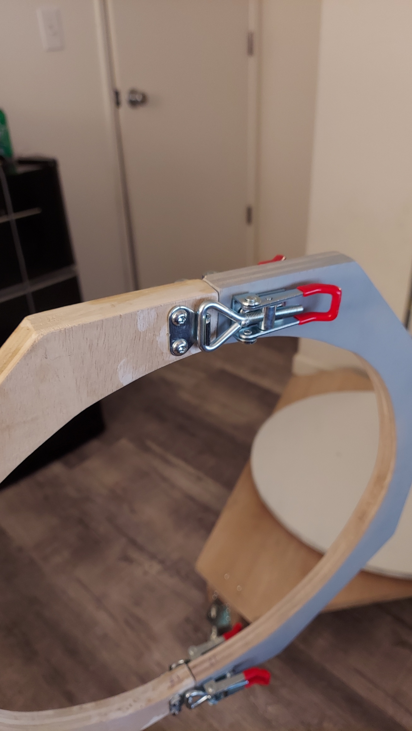
Documentation/Photos/Week 4/20221028_220442.jpg
