ninjaiceflame/MotorizedDobsonian/Documentation/Photos/Week 4/20221028_220453.jpg

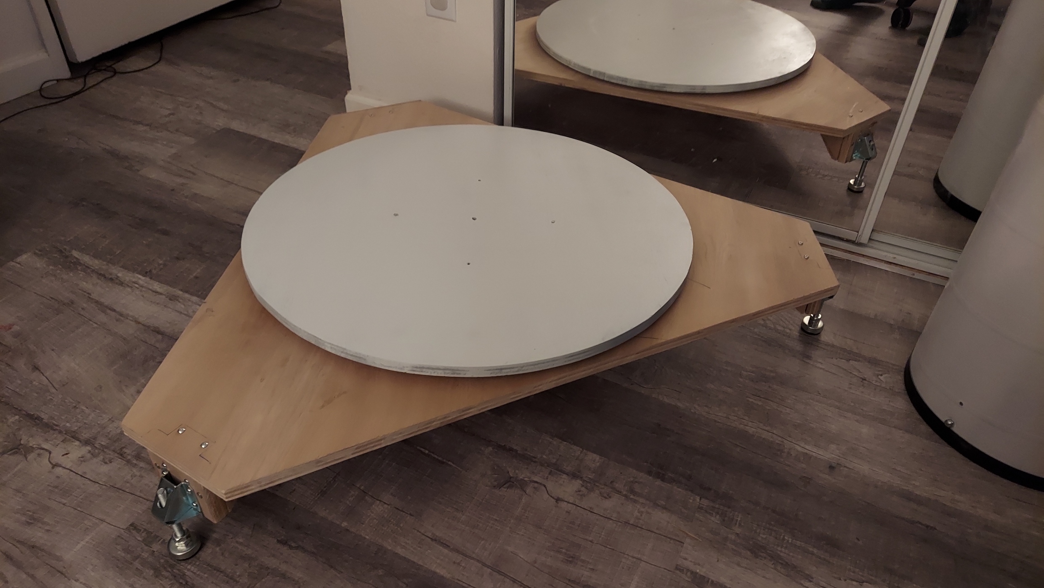
Documentation/Photos/Week 4/20221028_220453.jpg
