ninjaiceflame/MotorizedDobsonian/Documentation/Photos/Week 4/20221028_230617.jpg

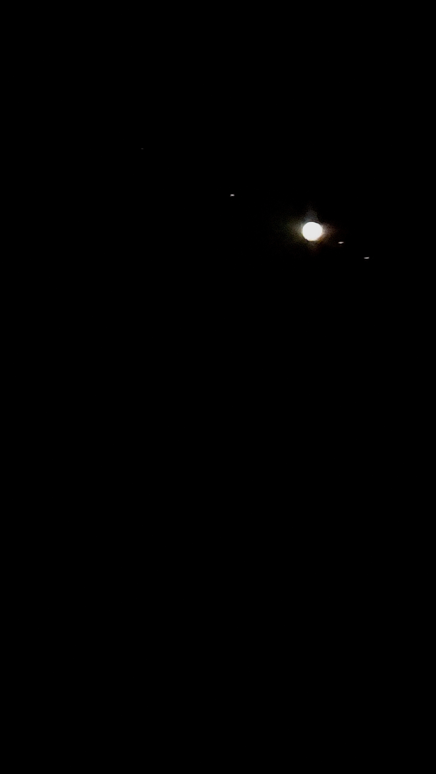
Documentation/Photos/Week 4/20221028_230617.jpg
