ninjaiceflame/MotorizedDobsonian/Documentation/Photos/Week 5/20221029_182247.jpg

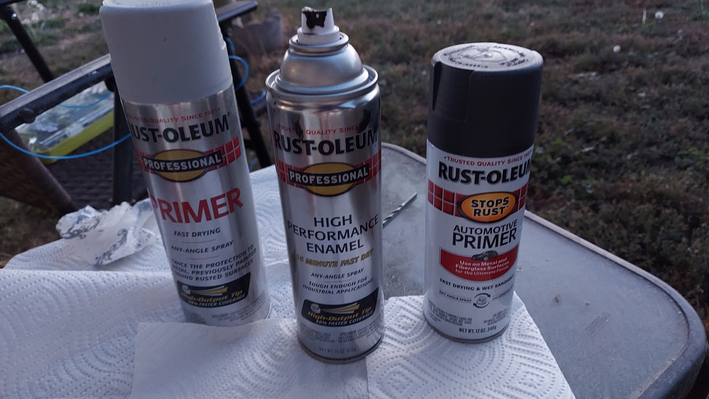
Documentation/Photos/Week 5/20221029_182247.jpg
