ninjaiceflame/MotorizedDobsonian/Documentation/Photos/Week 5/20221103_194221.jpg

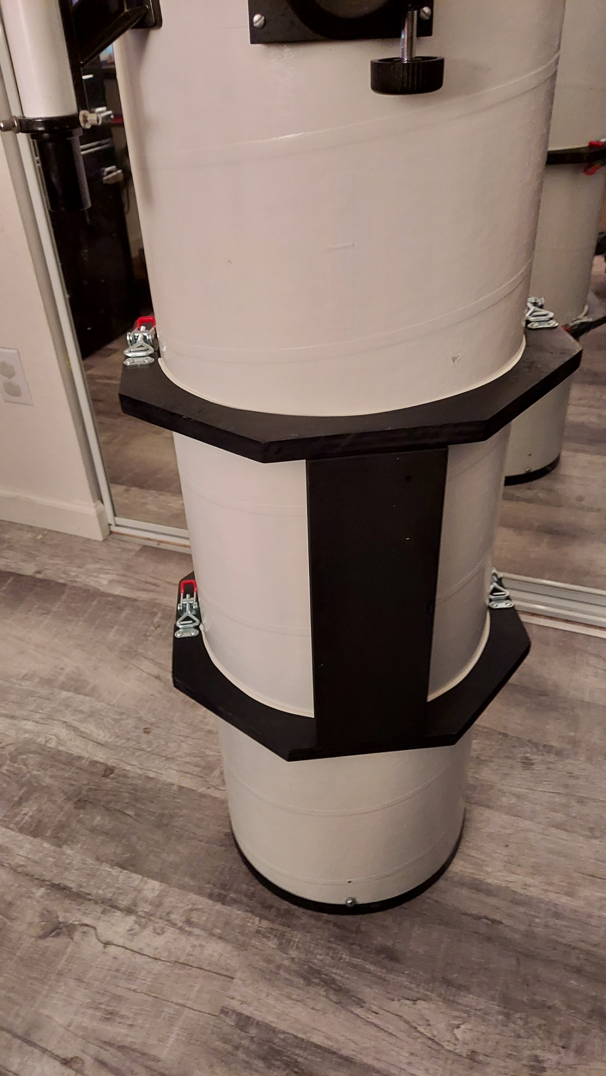
Documentation/Photos/Week 5/20221103_194221.jpg
