ninjaiceflame/MotorizedDobsonian/Documentation/Photos/Week 5/20221103_194241.jpg

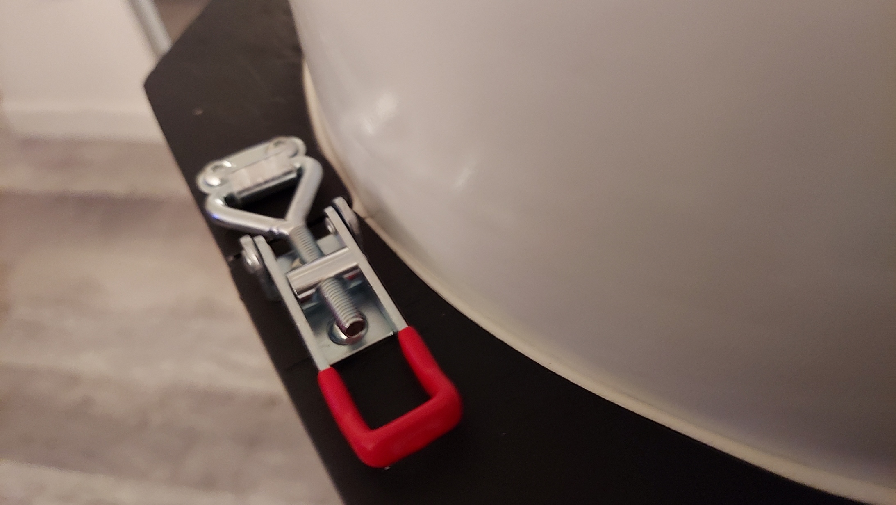
Documentation/Photos/Week 5/20221103_194241.jpg
