ninjaiceflame/MotorizedDobsonian/Documentation/Photos/Week 5/20221104_233533.jpg

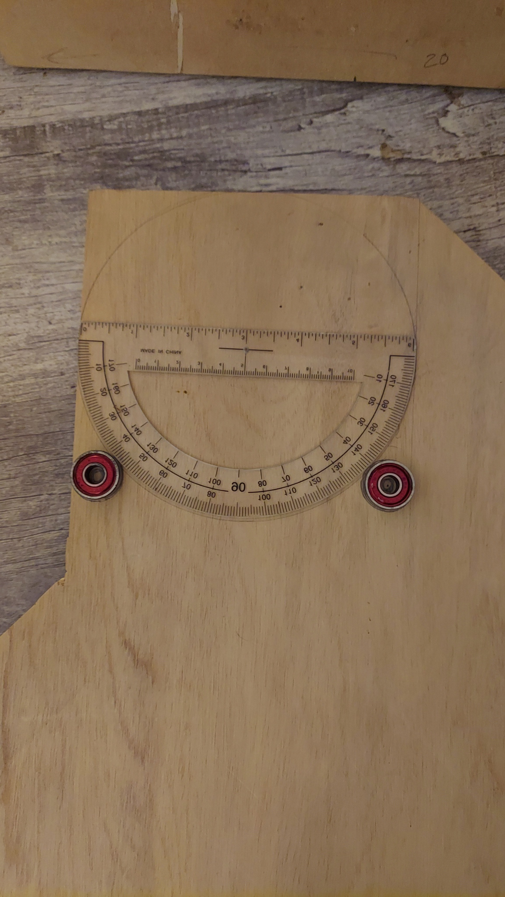
Documentation/Photos/Week 5/20221104_233533.jpg
