ninjaiceflame/MotorizedDobsonian/Documentation/Photos/Week 5/20221107_072411.jpg

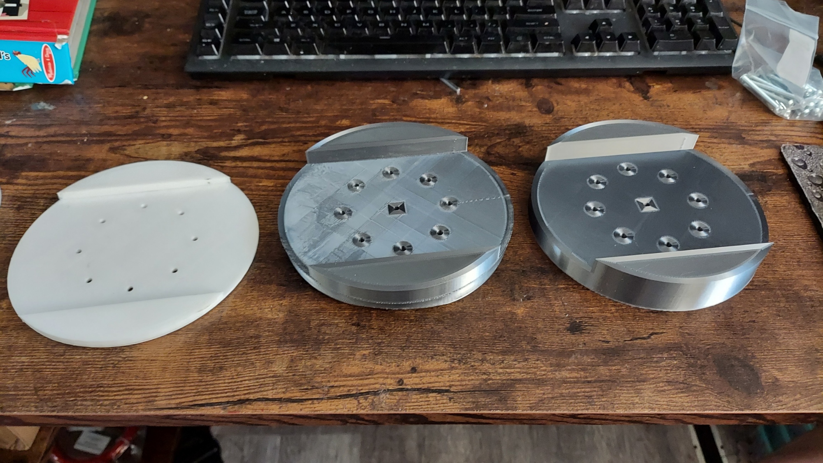
Documentation/Photos/Week 5/20221107_072411.jpg
