ninjaiceflame/MotorizedDobsonian/Documentation/Photos/Week 5/Capture.PNG

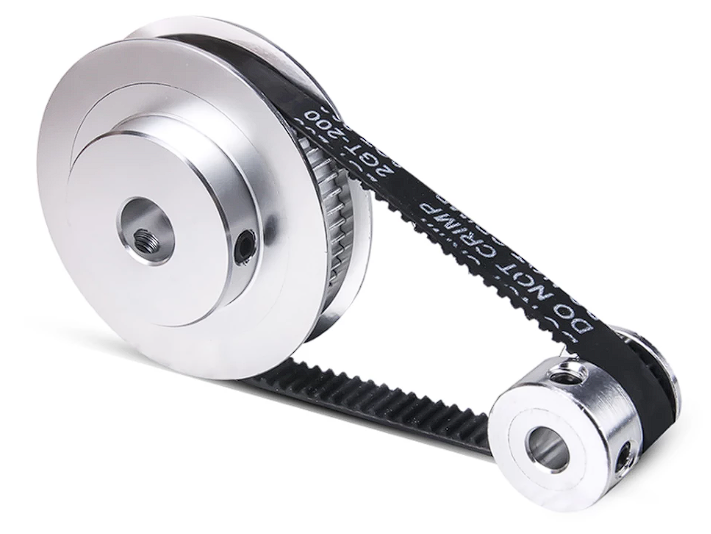
Documentation/Photos/Week 5/Capture.PNG
