ninjaiceflame/MotorizedDobsonian/Documentation/Photos/Week 5/rocker wheel front.PNG

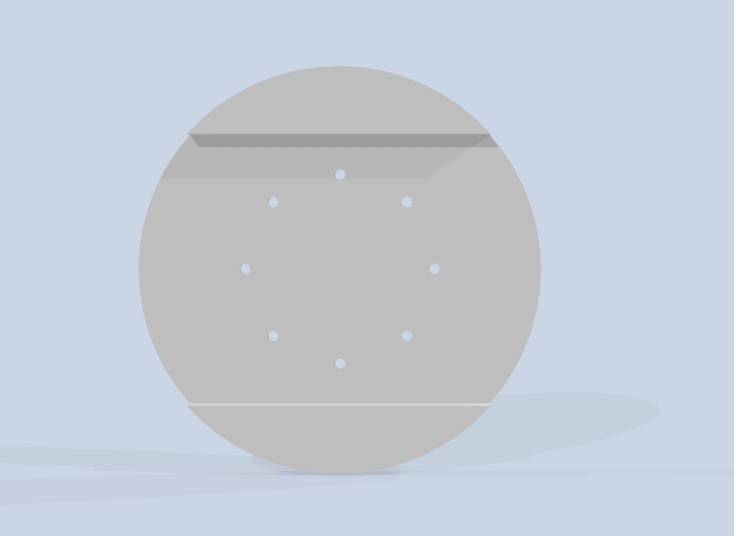
Documentation/Photos/Week 5/rocker wheel front.PNG
