ninjaiceflame/MotorizedDobsonian/Documentation/Photos/Week 9/20230316_094608.jpg

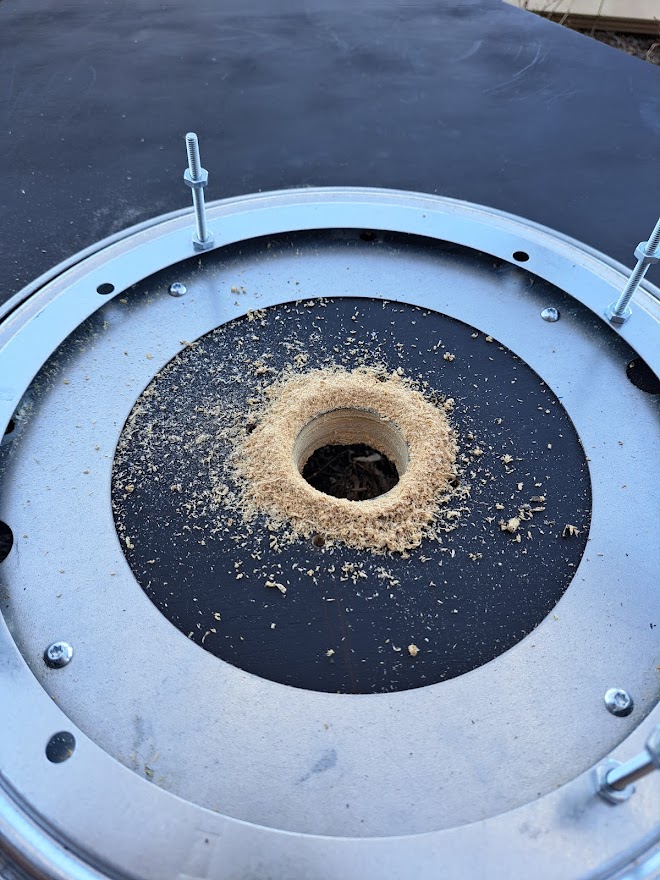
Documentation/Photos/Week 9/20230316_094608.jpg
