ninjaiceflame/MotorizedDobsonian/Documentation/Photos/Week 9/20230316_103907.jpg

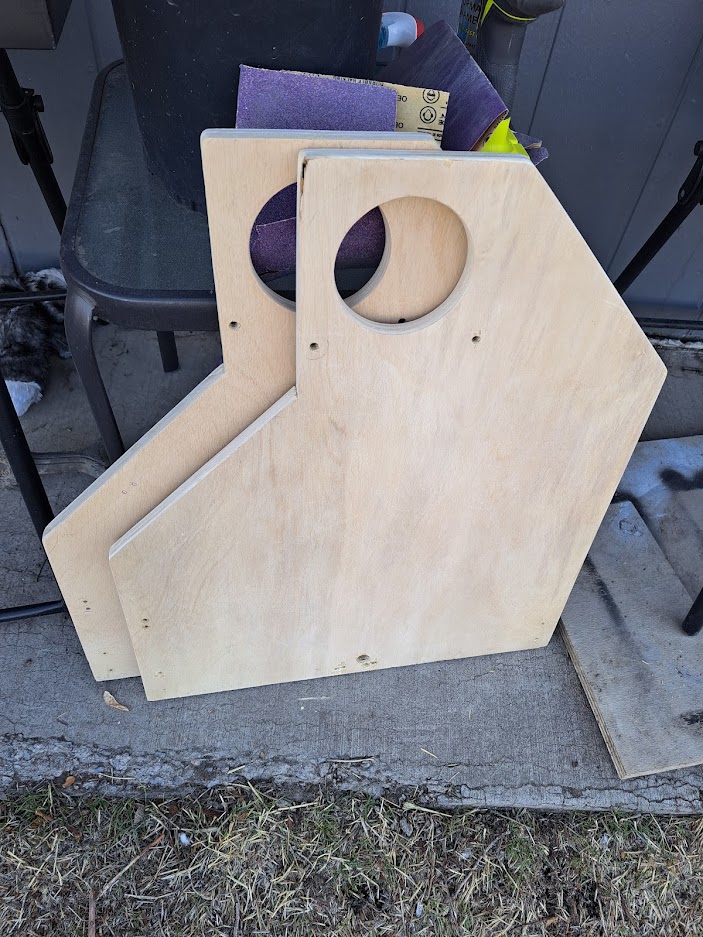
Documentation/Photos/Week 9/20230316_103907.jpg
