ninjaiceflame/MotorizedDobsonian/Documentation/Photos/Week 9/20230317_072426.jpg

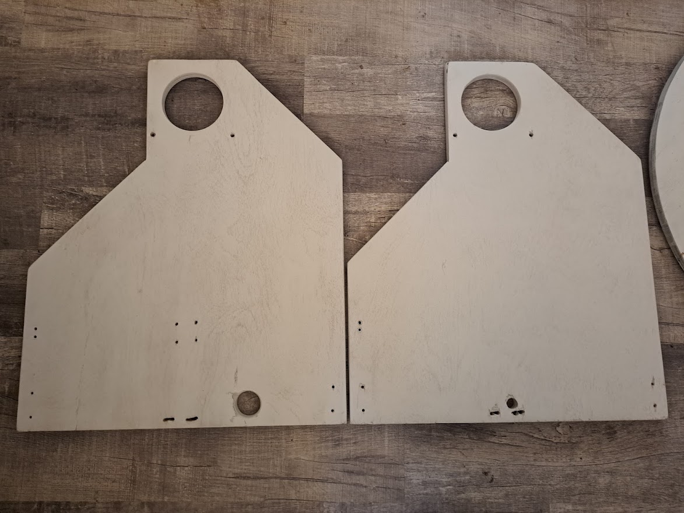
Documentation/Photos/Week 9/20230317_072426.jpg
