ninjaiceflame/MotorizedDobsonian/Documentation/Photos/Week 9/20230317_074425.jpg

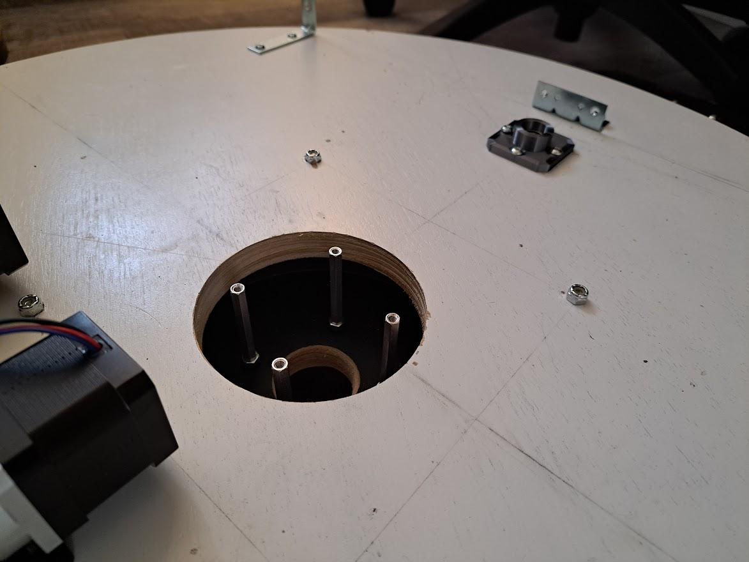
Documentation/Photos/Week 9/20230317_074425.jpg
