ninjaiceflame/MotorizedDobsonian/Documentation/Photos/Week 9/20230317_084959.jpg

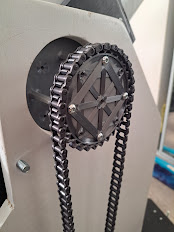
Documentation/Photos/Week 9/20230317_084959.jpg
