ninjaiceflame/MotorizedDobsonian/Documentation/Photos/Week 9/20230317_085002.jpg

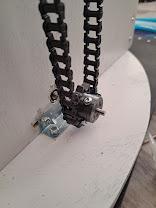
Documentation/Photos/Week 9/20230317_085002.jpg
