ninjaiceflame/MotorizedDobsonian/Documentation/Photos/Week 9/20230317_085010.jpg

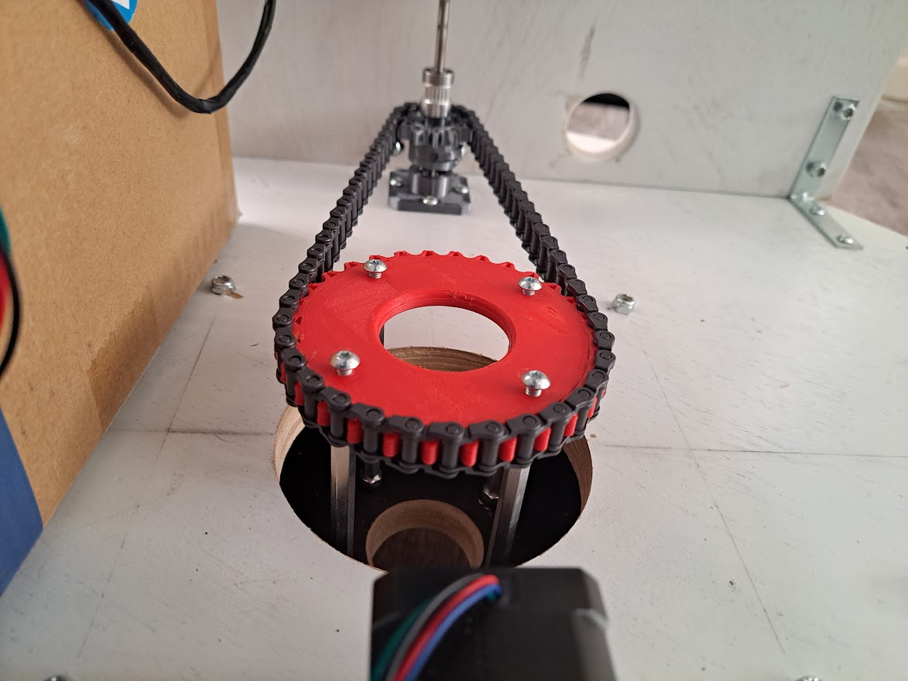
Documentation/Photos/Week 9/20230317_085010.jpg
