ninjaiceflame/MotorizedDobsonian/Documentation/Schedule.xlsx

Sheet: General Schedule
Task | Oct | Nov | Dec | Jan | Feb | Mar | Apr | May | Jun
Design Frame
Order Parts for Frame
Build Frame
Design Hardware
Order Hardware
Assemble Hardware
Develop Motor Software
Develop Tracking Software
Develop Networking Capabilities
Motor Testing
Motor Control Testing
Tracking Testing
Stretch Goals (If ahead of schedule)
Documentation
Engineer | 15 hrs. /week * 10 weeks = 150 hrs. @ $50 / hr. | $7500
Part Cost |  | $495.67
Total: |  | $7995.67

Sheet: Costs
Part | Link | Date Purchased | Price | Qty | Cost
Raspberry Pi | https://thepihut.com/products/raspberry-pi-3-model-b?src=raspberrypi | N/A (Already Owned) | $0.00 | 1 | $0.00
Nema 17 Stepper Motor | https://www.omc-stepperonline.com/nema-17-stepper-motor-l-40mm-gear-ratio-100-1-plm-series-planetary-gearbox-17hs15-1584s-plmg100 | 2022-10-28 | $37.16 | 2 | $74.32
DM542T Digital Stepper Driver | https://www.omc-stepperonline.com/digital-stepper-driver-1-0-4-2a-20-50vdc-for-nema-17-23-24-stepper-motor-dm542t | 2022-10-28 | $20.99 | 2 | $41.98
Power Supply | https://www.amazon.com/dp/B08GFQZFC1?ref=ppx_yo2ov_dt_b_product_details&th=1 | 2022-11-28 | $39.99 | 1 | $39.99
Timing Belt | https://www.amazon.com/dp/B07JKT5BZQ?psc=1&ref=ppx_yo2ov_dt_b_product_details | 2023-02-05 | $14.99 | 1 | $14.99
8mm Shaft | https://www.amazon.com/dp/B01B27MJC6?psc=1&ref=ppx_yo2ov_dt_b_product_details | 2023-02-05 | $7.99 | 1 | $7.99
8mm Bearings | https://www.amazon.com/dp/B07TNNX9YX?psc=1&ref=ppx_yo2ov_dt_b_product_details | 2023-02-05 | $6.99 | 1 | $6.99
5mm to 8mm Coupling | https://www.amazon.com/dp/B07RMZCLZ3?psc=1&ref=ppx_yo2ov_dt_b_product_details | 2023-02-05 | $12.99 | 1 | $12.99
3.3V to 5V Level Shifter | https://www.amazon.com/dp/B06XWVZHZJ?psc=1&ref=ppx_yo2ov_dt_b_product_details | 2023-02-05 | $8.99 | 1 | $8.99
Dobsonian Base |  |  | $134.30 | 1 | $134.30
Tube Assembly |  |  | $67.95 | 1 | $67.95
Paint and Sandpaper |  |  | $48.96 | 1 | $48.96
Misc hardware (Bearings, Legs, Levels) |  |  | $61.76 | 1 | $61.76
Shipping |  |  | $26.41 | 1 | $26.41
 |  |  |  | Total | $547.62
 |  |  |  |  | $8047.62

Sheet: Fall 2022 Schedule
Task | Week 1 | Week 2 | Week 3 | Week 4 | Week 5 | Week 6 | Week 7 | Week 8 | Week 9 | Week 10 | Week 11 | Week 12
Restore used telecope parts
Design bracket for vertical axis
Build bracket for vertical axis
Design base for horizontal axis
Build bracket for horizontal axis
Assemble functional non motorized telescope
Research motor types
Research processors / boards
Research hardware for network requirement
Decide motor type
Decide processor
Order motors
Order processor / board
Order power supply / peripherals
Design motor housing / gearing
Design board housing
Familiarize with processor / board
Familiarize with controlling motors
Stretch Goals (If ahead of schedule)
Documentation

Sheet: Winter 2023 Schedule
Task | Week 1 | Week 2 | Week 3 | Week 4 | Week 5 | Week 6 | Week 7 | Week 8 | Week 9 | Week 10 | Week 11 | Legend:
1. Finish non-motorized telescope assembly. |  |  |  |  |  |  |  |  |  |  |  | Complete
a) Drill holes into turntable and assemble uprights.
b) Drill holes and screw in horizontal struct piece.
c) Paint unfinished pieces |  |  |  |  |  |  |  |  |  |  |  | In progress
2. Create gearing system.
a) Design and print large pulley gear.
b) Order smaller gear and timing belts. |  |  |  |  |  |  |  |  |  |  |  | Not Started
3. Connect power adapter to power supply.
4. Connect power supply to stepper drivers.
5. Connect level shifter for the 3.3V I/O of Raspberry Pi to 5V of the stepper motor driver.
6. Develop software to drive motors.
a) Develop software to drive 2 motors at once.
7. Develop software to aim telescope.
a) Find the math behind aiming 2 axis control in 3D geometric space.
b) Apply the math to the code for driving the motors.
8. Develop software to track a coordinate as the earth rotates.
a) Develop software for calculating sidereal time.
9. Create or purchase board and electronic housing.

Sheet: Spring 2023 Schedule
Task | Week 1 | Week 2 | Week 3 | Week 4 | Week 5 | Week 6 | Week 7 | Week 8 | Week 9 | Week 10 | Week 11 | Legend:
Remake breadboard circuit on soldered board |  |  |  |  |  |  |  |  |  |  |  | Complete
Rewire all connections inside waterproof box
Finalize motor control
Generate motor testing plan |  |  |  |  |  |  |  |  |  |  |  | In progress
Generate control testing plan
Generate tracking testing plan
Test motors |  |  |  |  |  |  |  |  |  |  |  | Not Started
Test control program
Test tracking capabilities
Record results
Compile summary documentation
Stretch Goals:
Add a camera
Add GPS Module
Design and print replacement focuser
Find better solution to shaft connection on small gear
