ninjaiceflame/MotorizedDobsonian/Documentation/timesheet.xlsx

Day | Time Started | Time Ended | Total Hours | Description
Saturday |  |  | 0:00:00
Sunday |  |  | 0:00:00
Monday |  |  | 0:00:00
Tuesday |  |  | 0:00:00
Wednesday |  |  | 0:00:00
Thursday | 13:00:00 | 16:00:00 | 3:00:00 | Drilled holes and mounted weatherproof box
Friday | 20:00:00 | 22:00:00 | 2:00:00 | Started rewiring components, created schedule for term
Week 1 | Weekly Total: |  | 5:00:00
