ninjaiceflame/MotorizedDobsonian/Documentation/Schematics/Parts/rocker wheel.stp

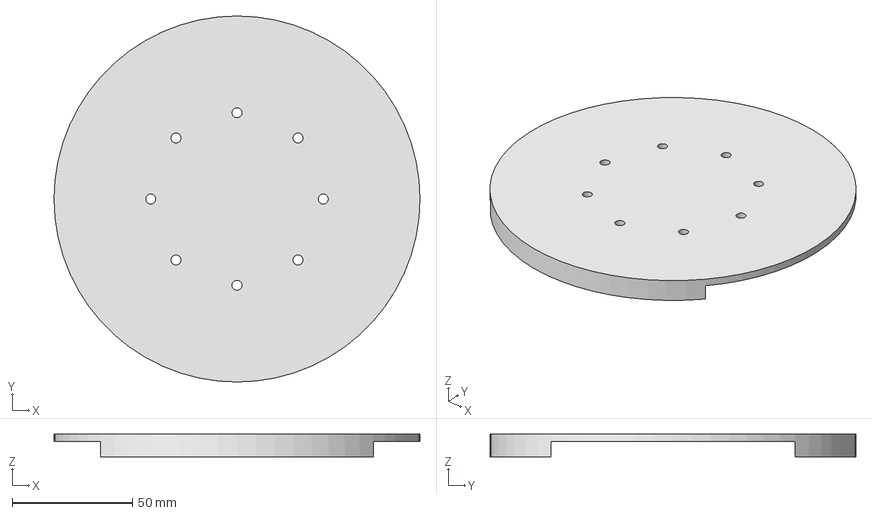
[picture p161: CAD file, 2023-05-26]
Documentation/Schematics/Parts/rocker wheel.stp
152.4 x 152.4 x 9.52 mm
