ninjaiceflame/MotorizedDobsonian/(list of files, cad)

Other CAD files:
Documentation/Schematics/Drawings/Tube Ring Joiner.dwg
Documentation/Schematics/Parts/Tube Ring Half.dwg
Documentation/Schematics/Drawings/base turntable.dwg
Documentation/Schematics/OldVersions/4x8plywood.0001.ipt
Documentation/Schematics/OldVersions/Bracket.0003.ipt
Documentation/Schematics/Parts/12in lazy susan.iam
Documentation/Schematics/Parts/4x8plywood.ipt
Documentation/Schematics/Parts/Assembly2.iam
Documentation/Schematics/Parts/Bracket.ipt
Documentation/Schematics/Parts/OldVersions/Assembly2.0002.iam
Documentation/Schematics/Parts/OldVersions/TelescopeAssembly.0006.iam
Documentation/Schematics/Parts/OldVersions/Triangle Base.0002.ipt
Documentation/Schematics/Parts/OldVersions/base side.0001.ipt
Documentation/Schematics/Parts/OldVersions/base turntable.0002.ipt
Documentation/Schematics/Parts/OldVersions/rocker wheel.0003.ipt
Documentation/Schematics/Parts/OldVersions/tube.0004.ipt
Documentation/Schematics/Parts/OldVersions/tubecap.0003.ipt
Documentation/Schematics/Parts/TelescopeAssembly.iam
Documentation/Schematics/Parts/Triangle Base.ipt
Documentation/Schematics/Parts/Tube Ring Half.ipt
Documentation/Schematics/Parts/Tube Ring Joiner.ipt
Documentation/Schematics/Parts/base side.ipt
Documentation/Schematics/Parts/base turntable.ipt
Documentation/Schematics/Parts/playwood.iam
Documentation/Schematics/Parts/rocker wheel.ipt
Documentation/Schematics/Parts/rocker wheel.stl
Documentation/Schematics/Parts/tube.ipt
Documentation/Schematics/Parts/tubecap.ipt
