ninjaiceflame/MotorizedDobsonian/Documentation/Schematics/Drawings/Tube Ring Half.pdf

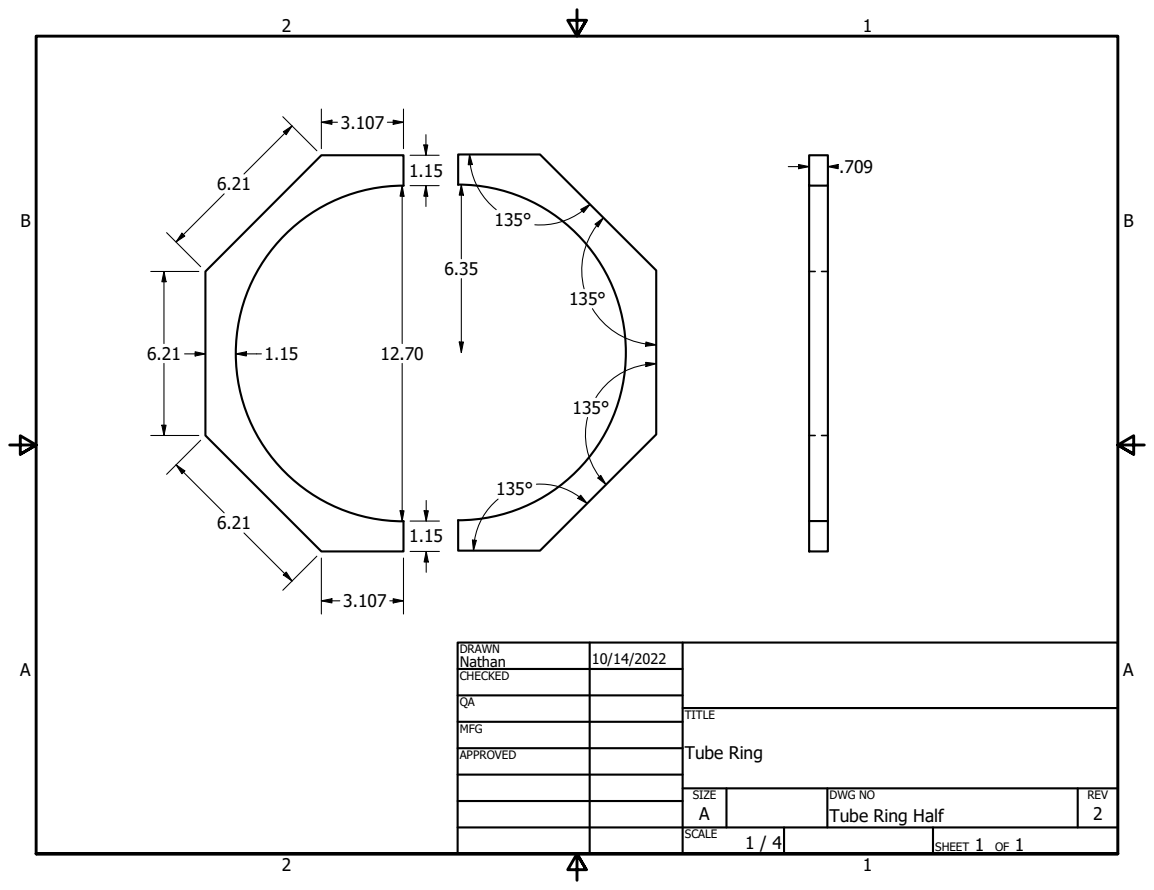
[picture p164: page 1]
Tube Ring

DRAWN Nathan | 10/14/2022

CHECKED

MFG

APPROVED

SIZE A | DWG NO Tube Ring Half | REV 2

SCALE 1 / 4 | | SHEET 1 OF 1
