ninjaiceflame/MotorizedDobsonian/Documentation/Schematics/Drawings/Tube Ring Joiner.pdf

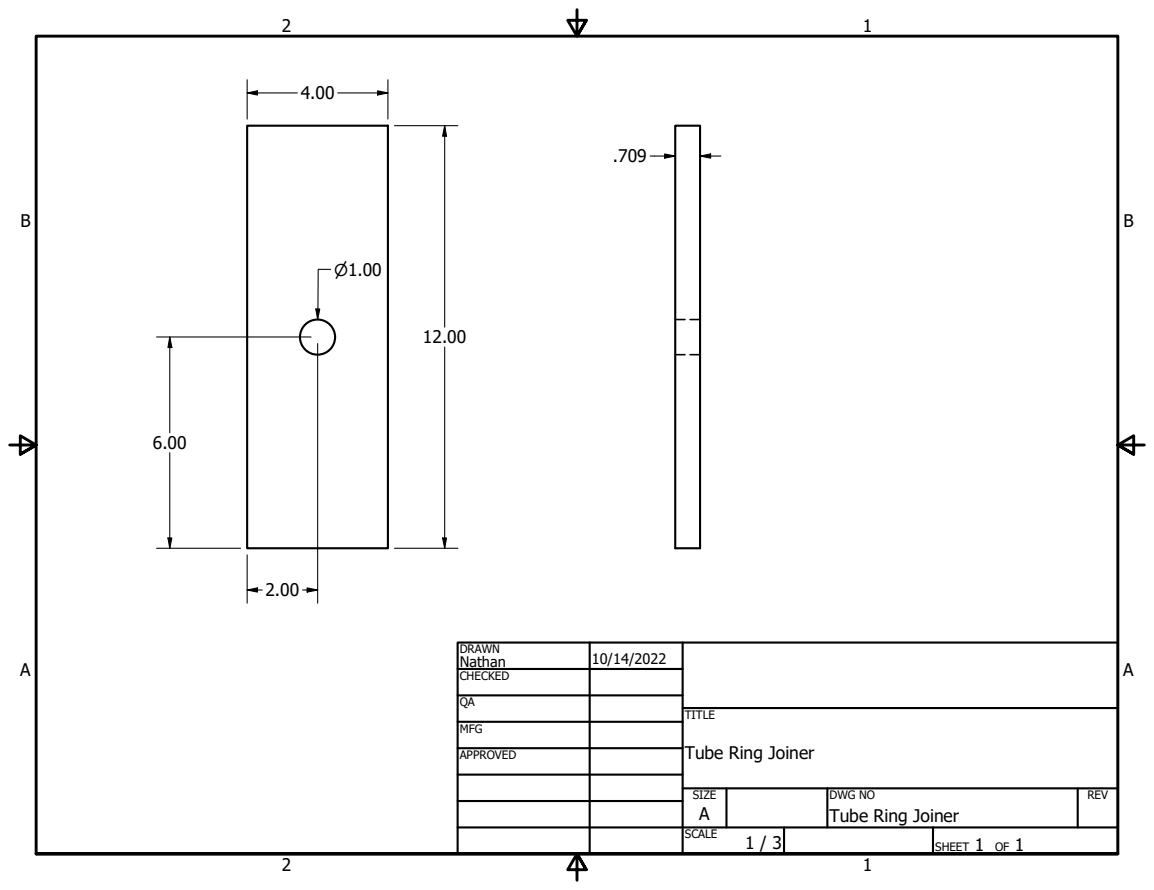
[picture p165: page 1]

DRAWN Nathan | 10/14/2022

CHECKED

MFG

APPROVED

Tube Ring Joiner

SIZE A | DWG NO Tube Ring Joiner | REV

SCALE 1 / 3 | | SHEET 1 OF 1
