ninjaiceflame/MotorizedDobsonian/Documentation/Schematics/Drawings/Rocker Box Side.pdf

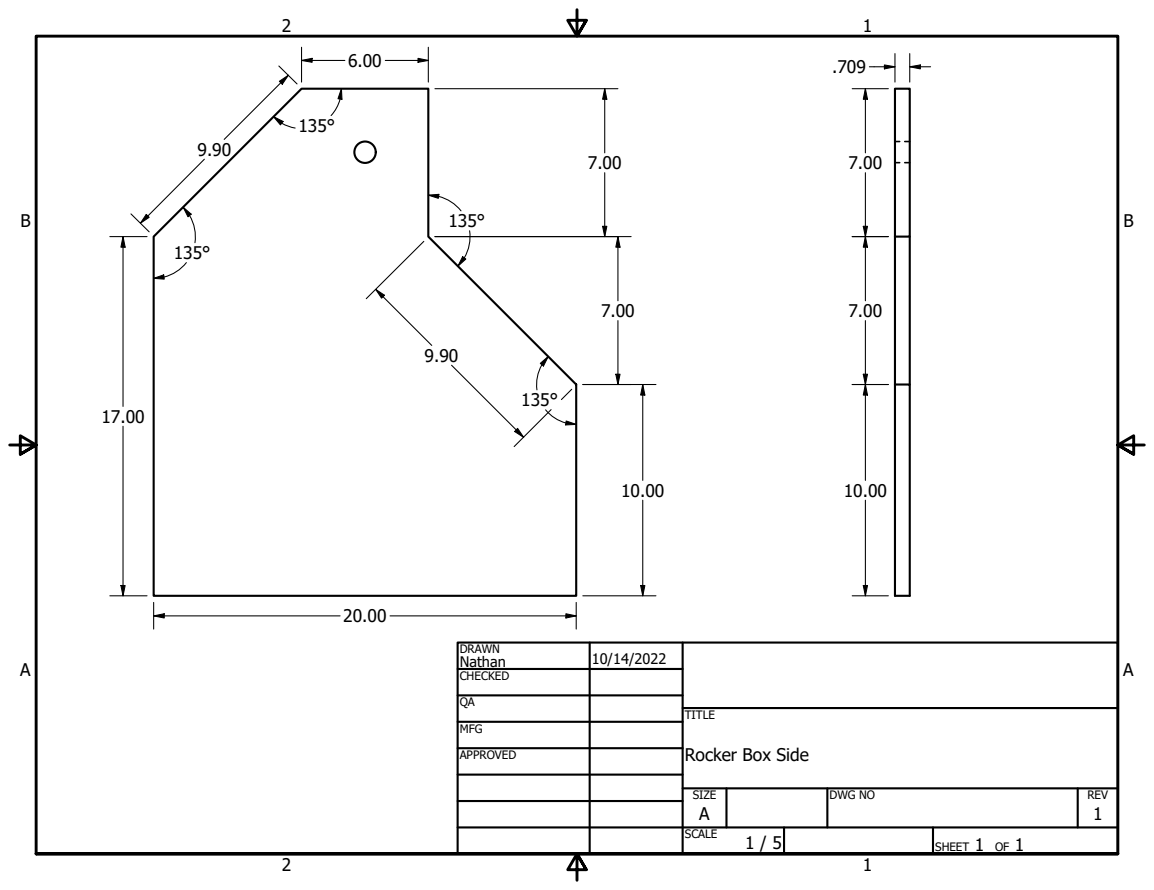
[picture p166: page 1]

DRAWN Nathan | 10/14/2022

CHECKED

MFG

APPROVED

Rocker Box Side

SIZE A | DWG NO | REV 1

SCALE 1 / 5 | | SHEET 1 OF 1
