ninjaiceflame/MotorizedDobsonian/Documentation/Schematics/Drawings/Turn Table Base.pdf

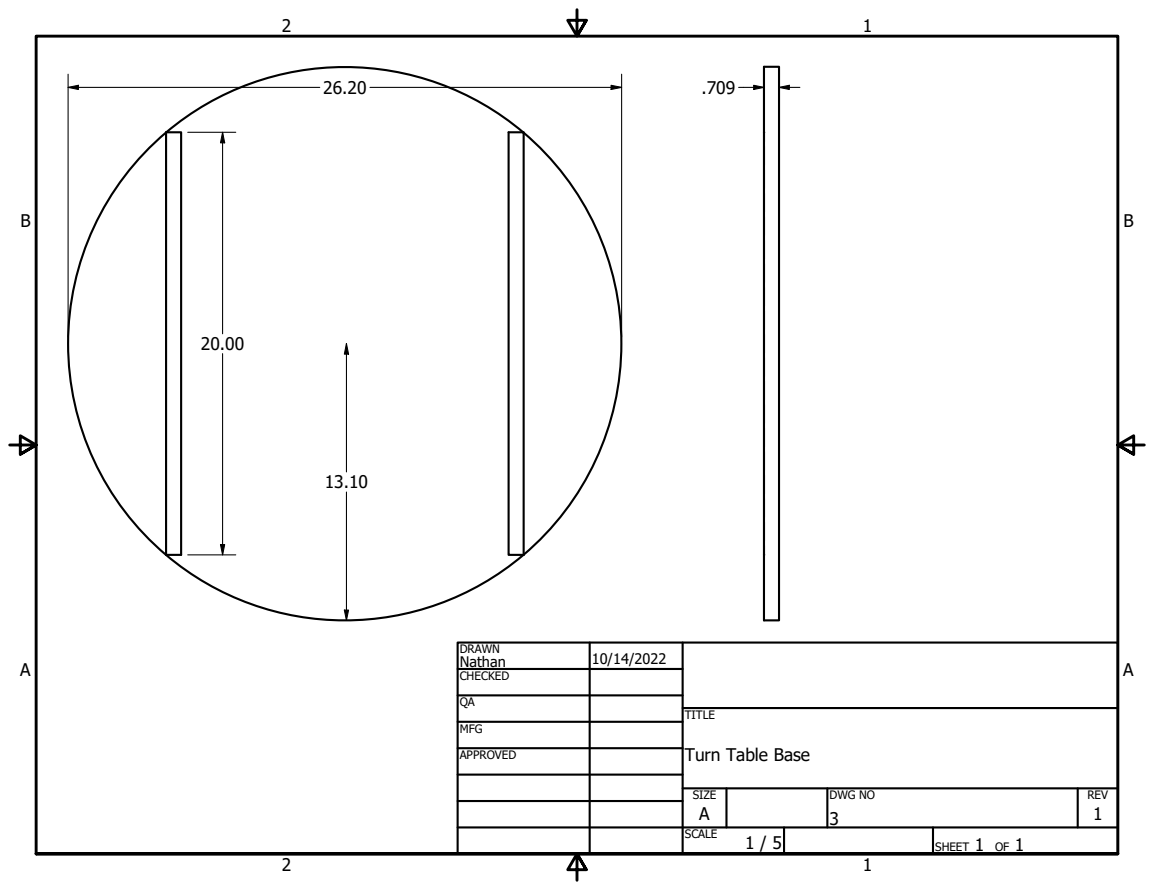
[picture p167: page 1]

DRAWN Nathan | 10/14/2022

CHECKED

MFG

APPROVED

Turn Table Base

SIZE A | DWG NO 3 | REV 1

SCALE 1 / 5 | | SHEET 1 OF 1
