ninjaiceflame/MotorizedDobsonian/(commit log)

2023-03-13 Started class for calculating sidereal time, only prints GMT as of now. Still using keyboard controls
2023-03-15 Fixed Julian function, converted all functions to static, ERA works, and added deg to DMS and DMS to deg.
    [main.cpp, sidereal.cpp, sidereal.h]
2023-03-16 Fixed math in hmsToDeg functions and overrides, starting coordinate files
    [coordinate.cpp, coordinate.h, main.cpp, sidereal.cpp, sidereal.h]
2023-03-17 Small update, Alt Az not working yet
    [coordinate.cpp, main.cpp, sidereal.cpp, sidereal.h]
2023-05-26 Added documentation, working on motor control code
    [12in lazy susan.iam, 4x8plywood.0001.ipt, 4x8plywood.ipt, Assembly2.0002.iam, Assembly2.iam, Bracket.0003.ipt, Bracket.ipt, Schedule.xlsx]
